asahiba/alpakka-improve/README.md

这是一个alpakka手柄的改版仓库
原项目地址：https://github.com/inputlabs
