asahiba/alpakka-improve/pcb/alpakka_D_C/preview.png

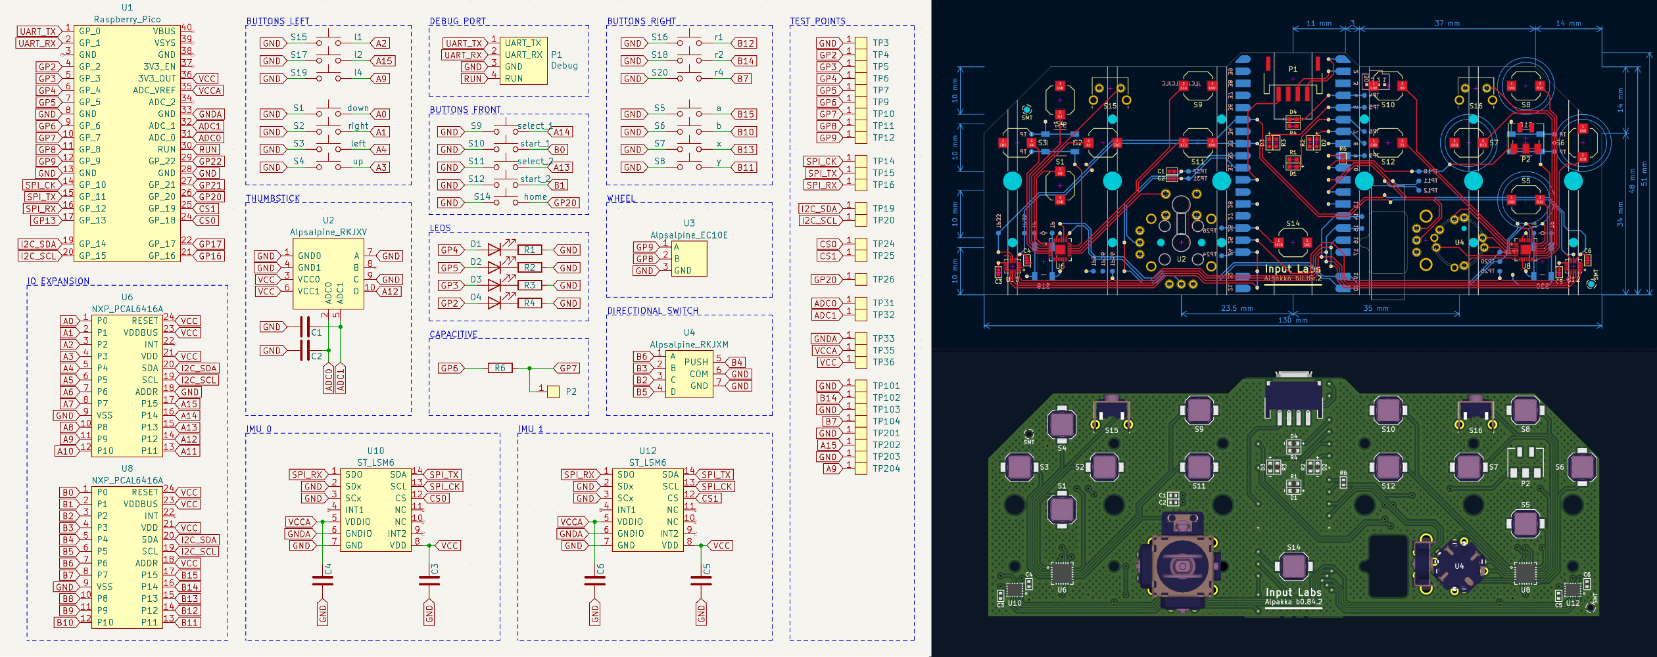
pcb/alpakka_D_C/preview.png
