asahiba/alpakka-improve/case/alpakka_D_C/stl/button_abxy.stl

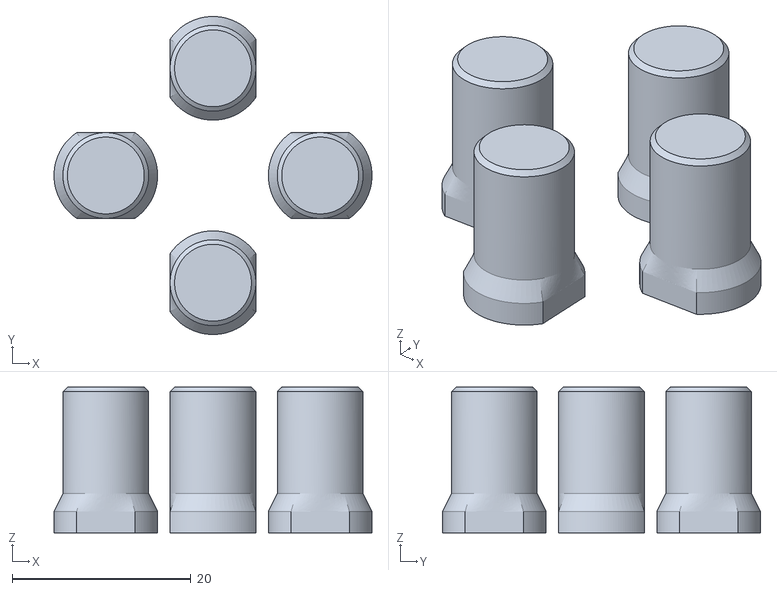
[picture p2: CAD file, 2025-08-04]
case/alpakka_D_C/stl/button_abxy.stl
35.6 x 35.6 x 16.3
