asahiba/alpakka-improve/case/alpakka_D_C/拓竹A1有线双摇杆标准化排版.3mf

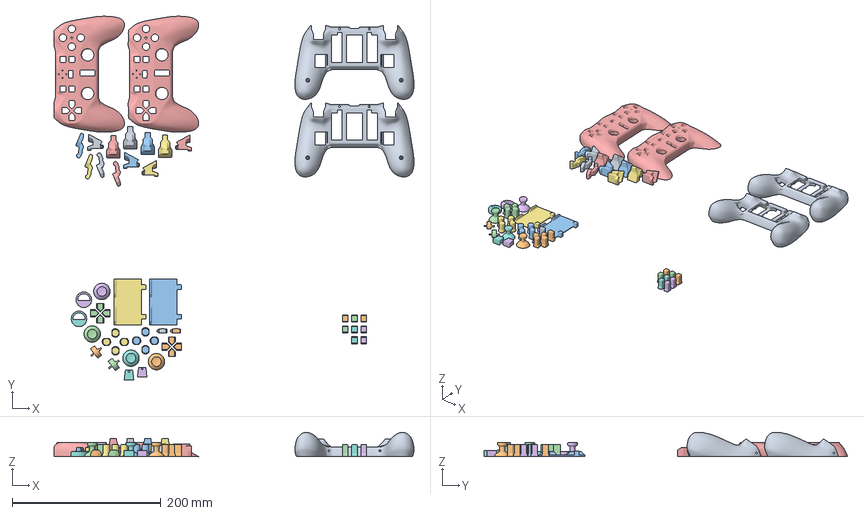
[picture p3: CAD file, 2025-08-04]
case/alpakka_D_C/拓竹A1有线双摇杆标准化排版.3mf
484.9 x 489.6 x 32.9 mm
case_back.stl x 2
007mm_select_4x.stl x 8
secondary_015mm_cover.stl x 2
Alpakka双摇杆[1.1.5][平整面壳][无八边形限位].stl x 2
button_abxy.stl x 2
primary_015mm_trigger_R2.stl x 4
button_dpad.stl x 2
007mm_thumbstick_L.stl x 4
primary_015mm_trigger_R4.stl x 2
primary_015mm_trigger_L4.stl x 2
secondary_015mm_wheel.stl x 2
primary_015mm_trigger_L1.stl x 2
secondary_007mm_wheel_core.stl x 2
primary_015mm_trigger_R1.stl x 2
any_015mm_wheel_holder.stl x 2
button_home.stl x 2
