asahiba/alpakka-improve/case/alpakka_D_C_M/B.stl

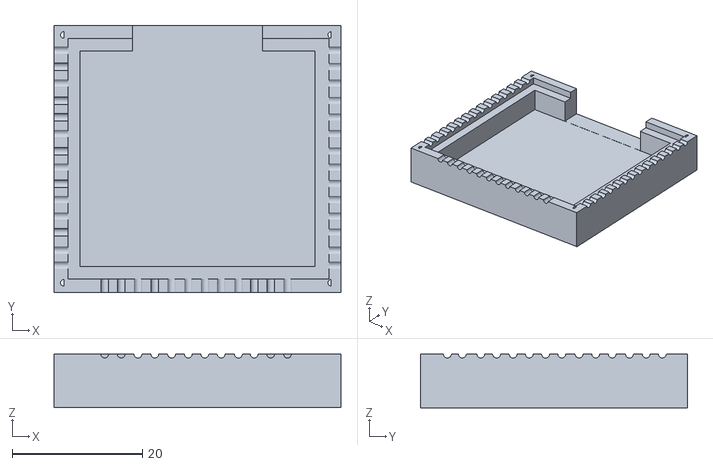
[picture p4: CAD file, 2025-08-05]
case/alpakka_D_C_M/B.stl
44.0 x 40.9 x 8.27
