asahiba/alpakka-improve/case/alpakka_D_W/A1无线圆润版标准化排版.3mf

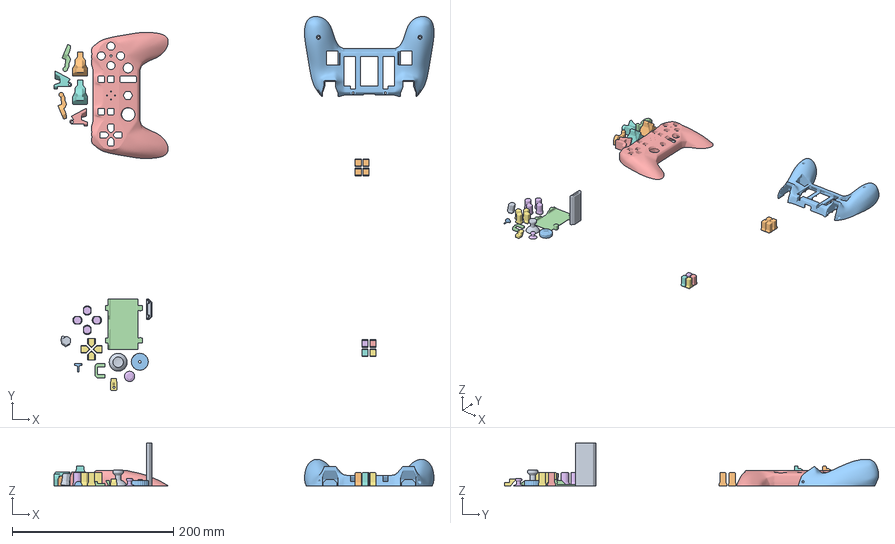
[picture p5: CAD file, 2025-08-04]
case/alpakka_D_W/A1无线圆润版标准化排版.3mf
470.7 x 463.5 x 52.7 mm
015mm_dongle_case.stl
组合体
case_back.stl
015mm_cover.stl
Alpakka无线版[官方1.0.1][圆润][无八边形限位].stl
button_abxy.stl
button_dpad.stl
015mm_trigger_L2.stl x 2
007mm_thumbstick_L.stl
015mm_wheel.stl
015mm_wheel_holder.stl
015mm_trigger_L4.stl
007mm_thumbstick_R.stl
015mm_anchors_2x.stl
015mm_trigger_R4.stl
007mm_home.stl
015mm_trigger_L1.stl
007mm_wheel_core.stl
015mm_trigger_R1.stl
007mm_select_4x.stl x 4
