asahiba/alpakka-improve/case/alpakka_S_C/Alpakka单摇杆home键.stl

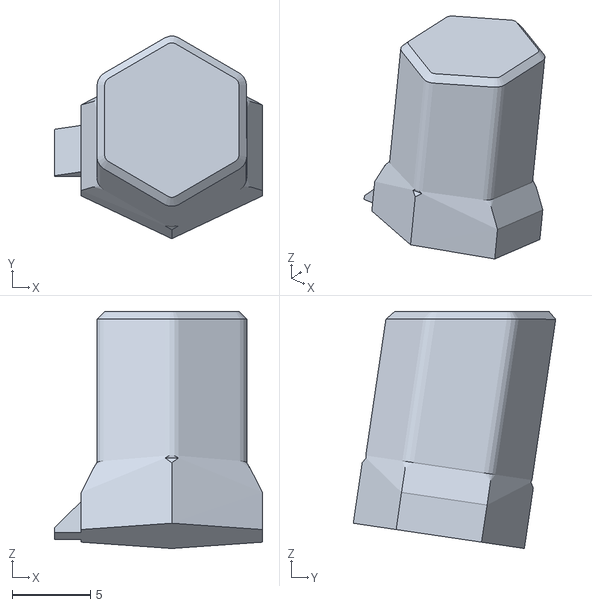
[picture p6: CAD file, 2025-08-04]
case/alpakka_S_C/Alpakka单摇杆home键.stl
13.3 x 12.9 x 15.2
