asahiba/alpakka-improve/case/alpakka_S_C/剩下的官方文件/any_015mm_wheel_holder.stl

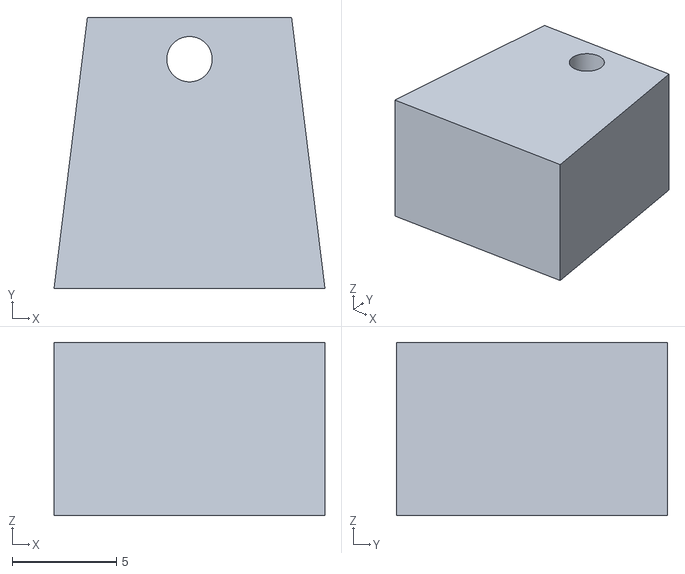
[picture p7: CAD file, 2025-08-04]
case/alpakka_S_C/剩下的官方文件/any_015mm_wheel_holder.stl
13.0 x 13.0 x 8.30
