asahiba/alpakka-improve/case/alpakka_D_C/stl/button_dpad.stl

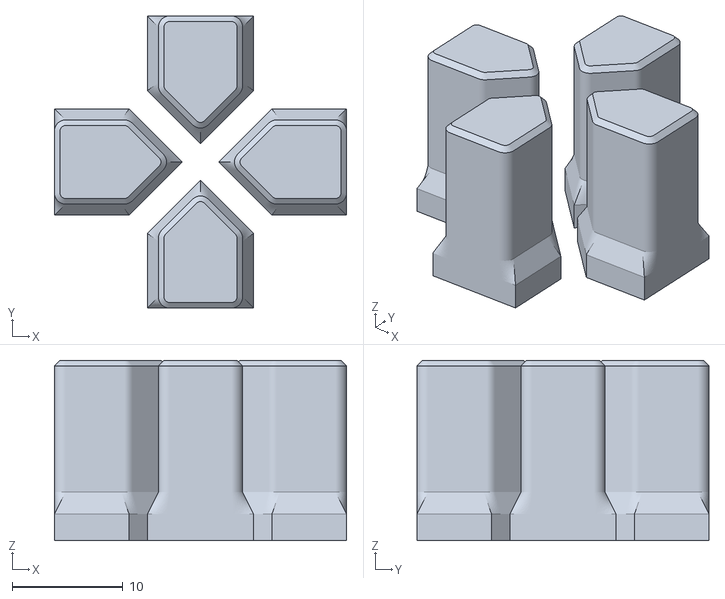
[picture p8: CAD file, 2025-08-04]
case/alpakka_D_C/stl/button_dpad.stl
26.4 x 26.4 x 16.3
