asahiba/alpakka-improve/case/alpakka_D_C_M/A.stl

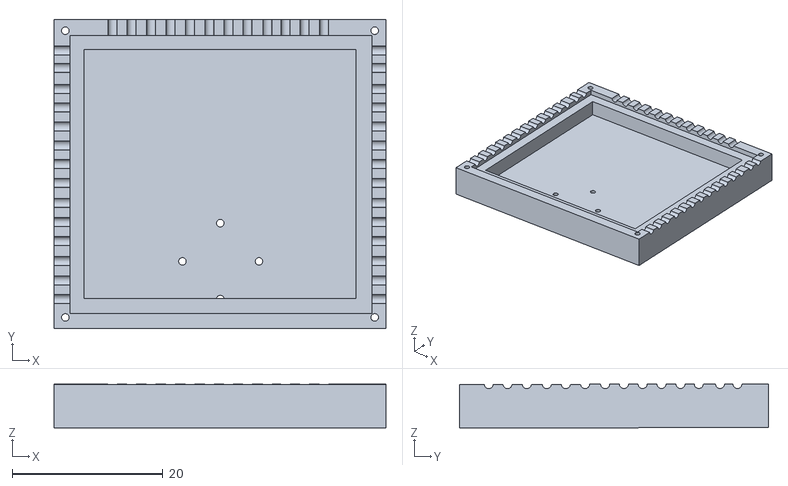
[picture p9: CAD file, 2025-08-05]
case/alpakka_D_C_M/A.stl
44.0 x 40.9 x 5.80
