asahiba/alpakka-improve/case/alpakka_S_C/Alpakka双摇杆home键.stl

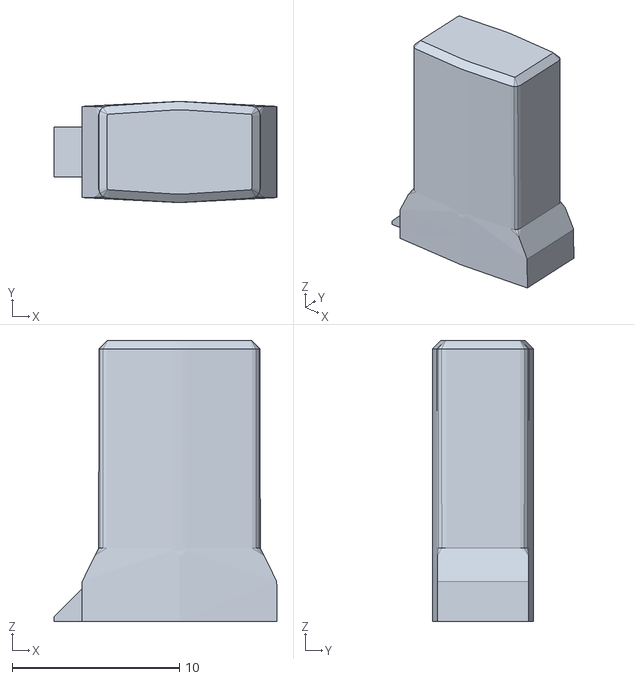
[picture p10: CAD file, 2025-08-04]
case/alpakka_S_C/Alpakka双摇杆home键.stl
13.3 x 6.06 x 16.8
