asahiba/alpakka-improve/case/alpakka_S_C/剩下的官方文件/secondary_015mm_wheel.stl

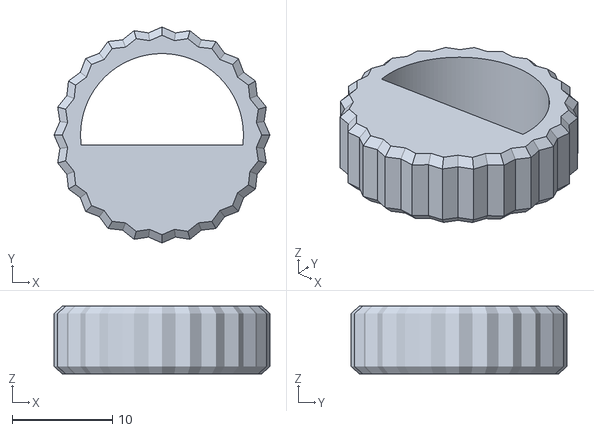
[picture p11: CAD file, 2025-08-04]
case/alpakka_S_C/剩下的官方文件/secondary_015mm_wheel.stl
21.5 x 21.5 x 6.75
