asahiba/alpakka-improve/case/alpakka_D_C/stl/case_front.stl

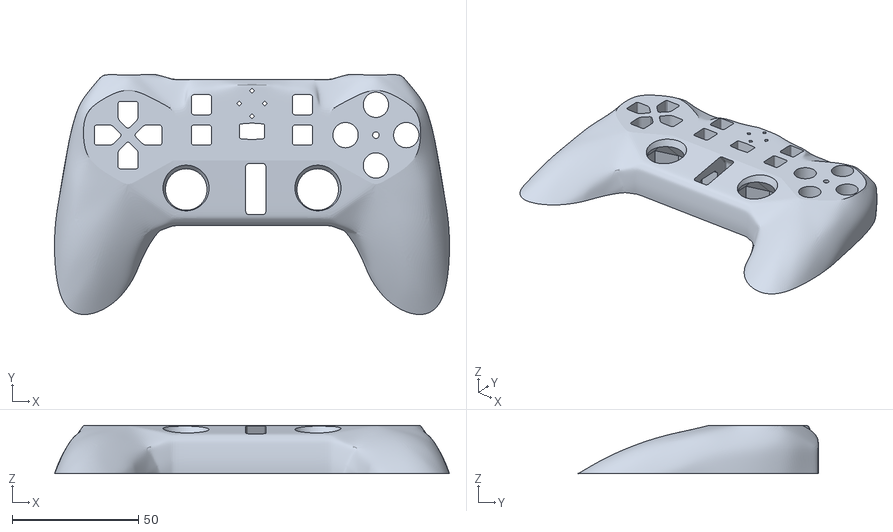
[picture p12: CAD file, 2025-08-04]
case/alpakka_D_C/stl/case_front.stl
156.2 x 94.9 x 19.0
