asahiba/alpakka-improve/case/alpakka_S_C/剩下的官方文件/secondary_007mm_wheel_core.stl

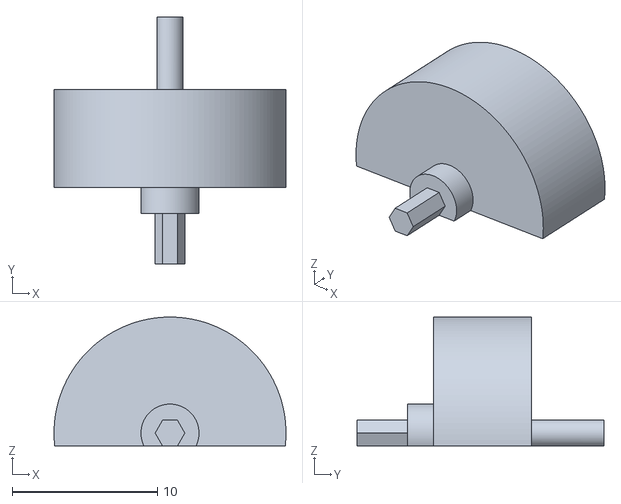
[picture p14: CAD file, 2025-08-04]
case/alpakka_S_C/剩下的官方文件/secondary_007mm_wheel_core.stl
16.0 x 17.1 x 8.89
