asahiba/alpakka-improve/case/alpakka_S_C/剩下的官方文件/primary_015mm_trigger_L4.stl

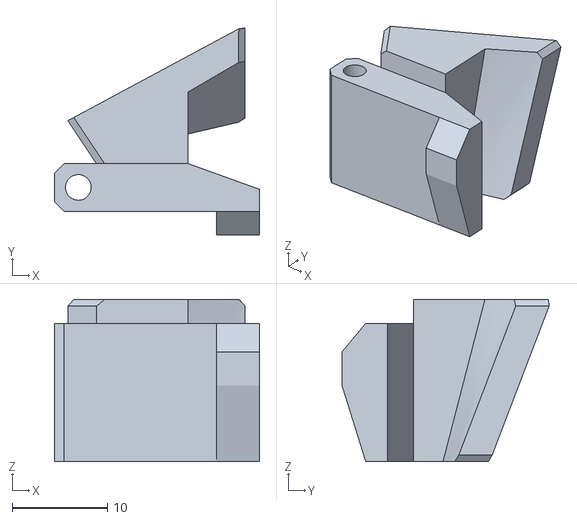
[picture p15: CAD file, 2025-08-04]
case/alpakka_S_C/剩下的官方文件/primary_015mm_trigger_L4.stl
21.5 x 21.7 x 17.0
