asahiba/alpakka-improve/case/alpakka_S_C/剩下的官方文件/primary_007mm_select_4x.stl

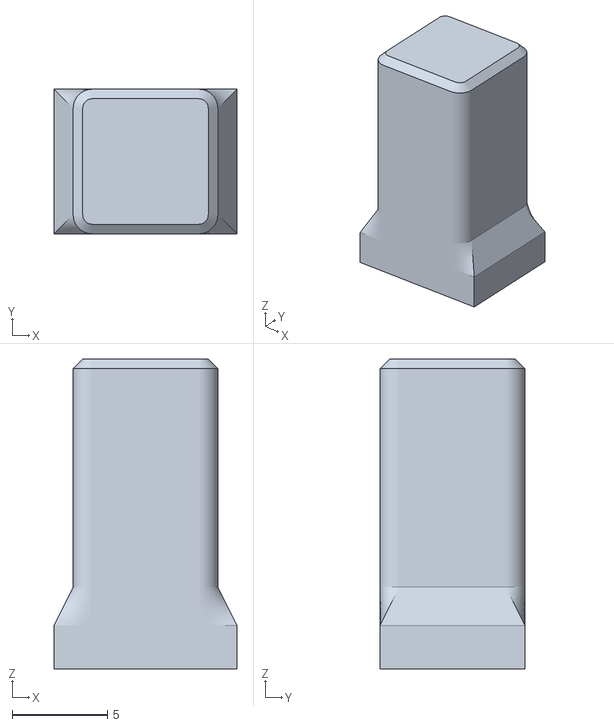
[picture p16: CAD file, 2025-08-04]
case/alpakka_S_C/剩下的官方文件/primary_007mm_select_4x.stl
9.60 x 7.60 x 16.3
