asahiba/alpakka-improve/case/alpakka_S_C/剩下的官方文件/secondary_015mm_cover.stl

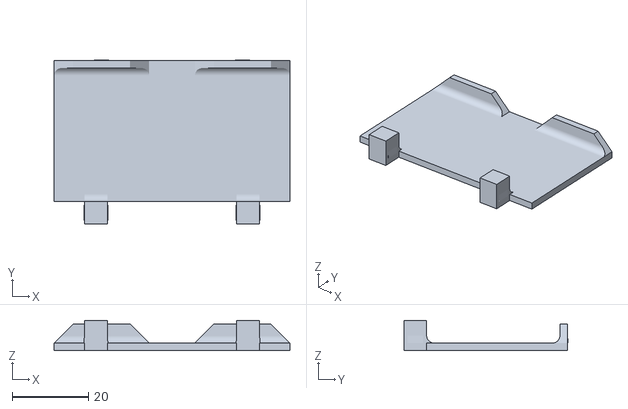
[picture p17: CAD file, 2025-08-04]
case/alpakka_S_C/剩下的官方文件/secondary_015mm_cover.stl
62.0 x 43.2 x 8.00
