asahiba/alpakka-improve/case/alpakka_S_C/剩下的官方文件/primary_015mm_trigger_L1.stl

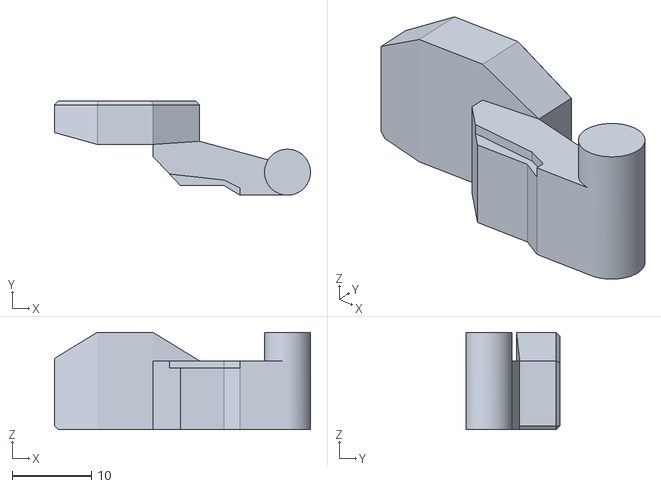
[picture p18: CAD file, 2025-08-04]
case/alpakka_S_C/剩下的官方文件/primary_015mm_trigger_L1.stl
32.3 x 11.9 x 12.3
