asahiba/alpakka-improve/case/alpakka_S_C/剩下的官方文件/primary_015mm_trigger_L2.stl

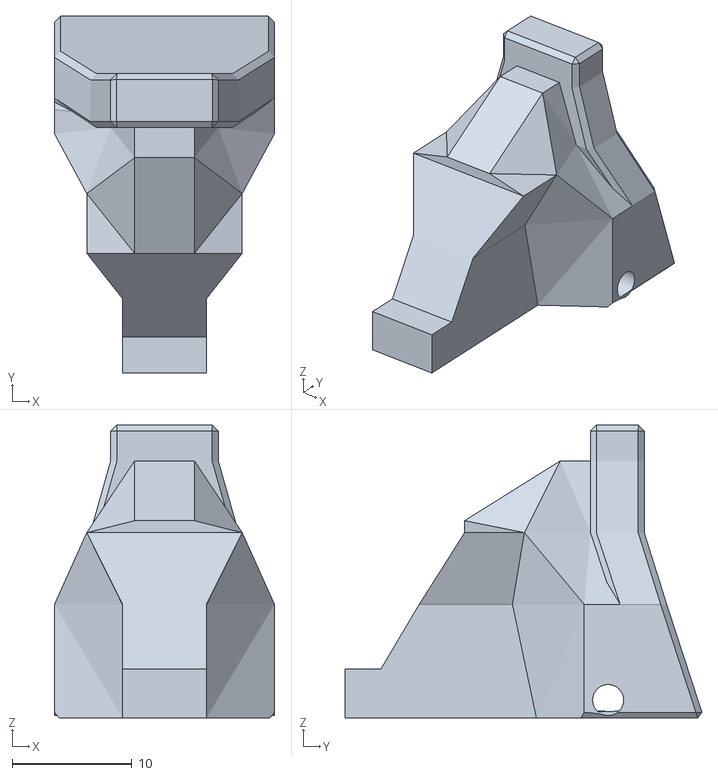
[picture p19: CAD file, 2025-08-04]
case/alpakka_S_C/剩下的官方文件/primary_015mm_trigger_L2.stl
18.4 x 29.8 x 24.5
