asahiba/alpakka-improve/(list of files, cad)

Other CAD files:
case/alpakka_S_C/Alpakka双摇杆[1.1.3]上壳.stl
case/alpakka_S_C/Alpakka单摇杆[优化3]上壳.stl
case/alpakka_S_C/剩下的官方文件/primary_015mm_trigger_R1.stl
case/alpakka_S_C/剩下的官方文件/primary_015mm_trigger_R4.stl
case/alpakka_D_C/blender/alpakka.blend
case/alpakka_D_C/blender/anchor.blend
case/alpakka_D_C/blender/button_abxy.blend
case/alpakka_D_C/blender/button_dpad.blend
case/alpakka_D_C/blender/button_home.blend
case/alpakka_D_C/blender/button_select.blend
case/alpakka_D_C/blender/case_back.blend
case/alpakka_D_C/blender/case_cover.blend
case/alpakka_D_C/blender/case_front.blend
case/alpakka_D_C/blender/hexagon.blend
case/alpakka_D_C/blender/hexagon_screwed.blend
case/alpakka_D_C/blender/lock.blend
case/alpakka_D_C/blender/pcb.blend
case/alpakka_D_C/blender/render.blend
case/alpakka_D_C/blender/scrollwheel.blend
case/alpakka_D_C/blender/shared.blend
case/alpakka_D_C/blender/soldering_stand.blend
case/alpakka_D_C/blender/thumbstick.blend
case/alpakka_D_C/blender/thumbstick_right.blend
case/alpakka_D_C/blender/trigger_R1.blend
case/alpakka_D_C/blender/trigger_R2.blend
case/alpakka_D_C/blender/trigger_R4.blend
case/alpakka_D_W/blender/alpakka.blend
case/alpakka_D_W/blender/anchor.blend
case/alpakka_D_W/blender/button_abxy.blend
case/alpakka_D_W/blender/button_dpad.blend
case/alpakka_D_W/blender/button_home.blend
case/alpakka_D_W/blender/button_select.blend
case/alpakka_D_W/blender/case_back.blend
case/alpakka_D_W/blender/case_cover.blend
case/alpakka_D_W/blender/case_front.blend
case/alpakka_D_W/blender/hexagon.blend
case/alpakka_D_W/blender/hexagon_screwed.blend
case/alpakka_D_W/blender/lock.blend
case/alpakka_D_W/blender/scrollwheel.blend
case/alpakka_D_W/blender/shared.blend
case/alpakka_D_W/blender/soldering_stand.blend
case/alpakka_D_W/blender/thumbstick.blend
case/alpakka_D_W/blender/trigger_R1.blend
case/alpakka_D_W/blender/trigger_R2.blend
case/alpakka_D_W/blender/trigger_R4.blend
