asahiba/alpakka-improve/pcb/alpakka_D_C_M/alpakka_D_C_M.kicad_pcb

## KiCad design pcb/alpakka_D_C_M/alpakka_D_C_M.kicad_pcb (2025-08-04)

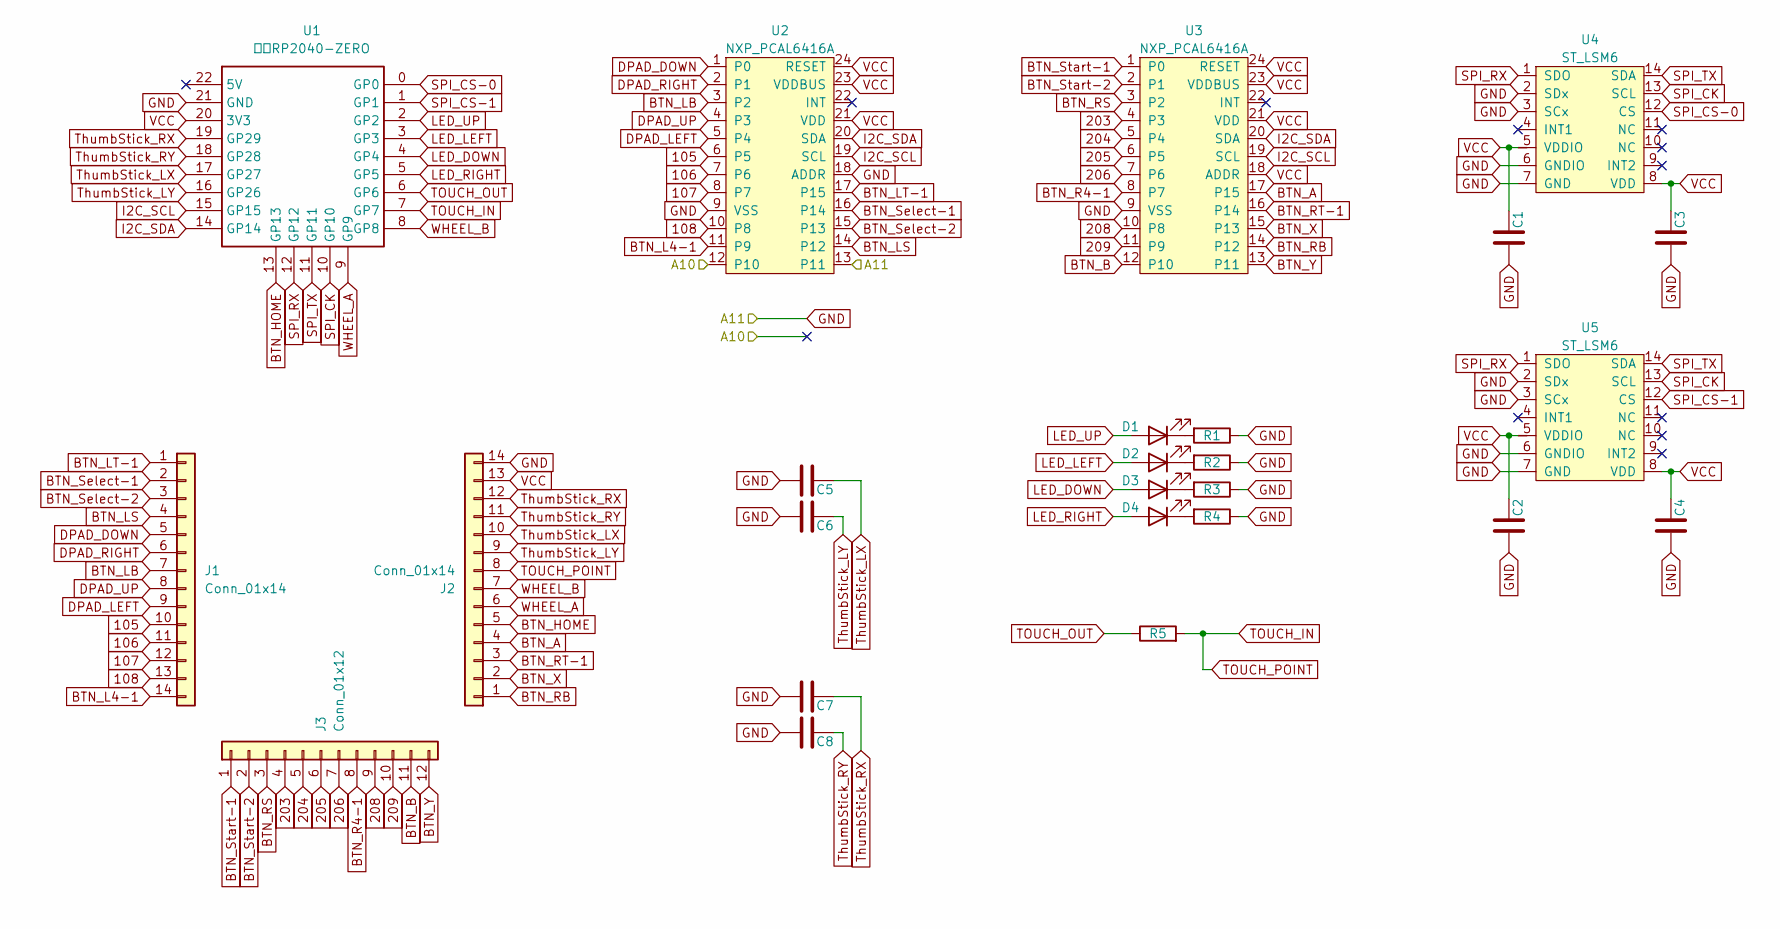
[picture p20: schematic alpakka_D_C_M.kicad_sch]

Parts:
C1, C2, C3, C4, C5, C6, C7, C8: C; 0402; LCSC C1525
D1, D2, D3, D4: Diode; 0603_d; LCSC C2290
J1, J2: Conn_01x14; 邮票孔排针1x14PIN_2.54MM
J3: Conn_01x12; 邮票孔排针1x12PIN_2.54MM
R1, R2, R3, R4: R; 0603; LCSC C22950
R5: R6; 0402; LCSC C11616
U1: 微雪RP2040-ZERO; RP2040-ZERO_SMT
U2, U3: NXP_PCAL6416A; QFN24; LCSC C2652287
U4, U5: ST_LSM6; LGA14; LCSC C784817

Connections:
105: J1.10, U2.6 (P5)
106: J1.11, U2.7 (P6)
107: J1.12, U2.8 (P7)
108: J1.13, U2.10 (P8)
203: J3.4, U3.4 (P3)
204: J3.5, U3.5 (P4)
205: J3.6, U3.6 (P5)
206: J3.7, U3.7 (P6)
208: J3.9, U3.10 (P8)
209: J3.10, U3.11 (P9)
/A10: U2.12 (P10)
BTN_A: J2.4, U3.17 (P15)
BTN_B: J3.11, U3.12 (P10)
BTN_HOME: J2.5, U1.13 (GP13)
BTN_L4-1: J1.14, U2.11 (P9)
BTN_LB: J1.7, U2.3 (P2)
BTN_LS: J1.4, U2.14 (P12)
BTN_LT-1: J1.1, U2.17 (P15)
BTN_R4-1: J3.8, U3.8 (P7)
BTN_RB: J2.1, U3.14 (P12)
BTN_RS: J3.3, U3.3 (P2)
BTN_RT-1: J2.3, U3.16 (P14)
BTN_Select-1: J1.2, U2.16 (P14)
BTN_Select-2: J1.3, U2.15 (P13)
BTN_Start-1: J3.1, U3.1 (P0)
BTN_Start-2: J3.2, U3.2 (P1)
BTN_X: J2.2, U3.15 (P13)
BTN_Y: J3.12, U3.13 (P11)
DPAD_DOWN: J1.5, U2.1 (P0)
DPAD_LEFT: J1.9, U2.5 (P4)
DPAD_RIGHT: J1.6, U2.2 (P1)
DPAD_UP: J1.8, U2.4 (P3)
GND: C1.1, C2.1, C3.1, C4.1, C5.1, C6.1, C7.1, C8.1, J2.14, R1.1, R2.1, R3.1, R4.1, U1.21 (GND), U2.9 (VSS), U2.13 (P11), U2.18 (ADDR), U3.9 (VSS), U4.2 (SDx), U4.3 (SCx), U4.6 (GNDIO), U4.7 (GND), U5.2 (SDx), U5.3 (SCx), U5.6 (GNDIO), U5.7 (GND)
I2C_SCL: U1.15 (GP15), U2.19 (SCL), U3.19 (SCL)
I2C_SDA: U1.14 (GP14), U2.20 (SDA), U3.20 (SDA)
LED_DOWN: D3.2 (A), U1.4 (GP4)
LED_LEFT: D2.2 (A), U1.3 (GP3)
LED_RIGHT: D4.2 (A), U1.5 (GP5)
LED_UP: D1.2 (A), U1.2 (GP2)
unnamed: D1.1 (K), R1.2
unnamed: D2.1 (K), R2.2
unnamed: D3.1 (K), R3.2
unnamed: D4.1 (K), R4.2
SPI_CK: U1.10 (GP10), U4.13 (SCL), U5.13 (SCL)
SPI_CS-0: U1.0 (GP0), U4.12 (CS)
SPI_CS-1: U1.1 (GP1), U5.12 (CS)
SPI_RX: U1.12 (GP12), U4.1 (SDO), U5.1 (SDO)
SPI_TX: U1.11 (GP11), U4.14 (SDA), U5.14 (SDA)
TOUCH_IN: J2.8, R5.2, U1.7 (GP7)
TOUCH_OUT: R5.1, U1.6 (GP6)
ThumbStick_LX: C5.2, J2.10, U1.17 (GP27)
ThumbStick_LY: C6.2, J2.9, U1.16 (GP26)
ThumbStick_RX: C7.2, J2.12, U1.19 (GP29)
ThumbStick_RY: C8.2, J2.11, U1.18 (GP28)
VCC: C1.2, C2.2, C3.2, C4.2, J2.13, U1.20 (3V3), U2.21 (VDD), U2.23 (VDDBUS), U2.24 (RESET), U3.18 (ADDR), U3.21 (VDD), U3.23 (VDDBUS), U3.24 (RESET), U4.5 (VDDIO), U4.8 (VDD), U5.5 (VDDIO), U5.8 (VDD)
WHEEL_A: J2.6, U1.9 (GP9)
WHEEL_B: J2.7, U1.8 (GP8)

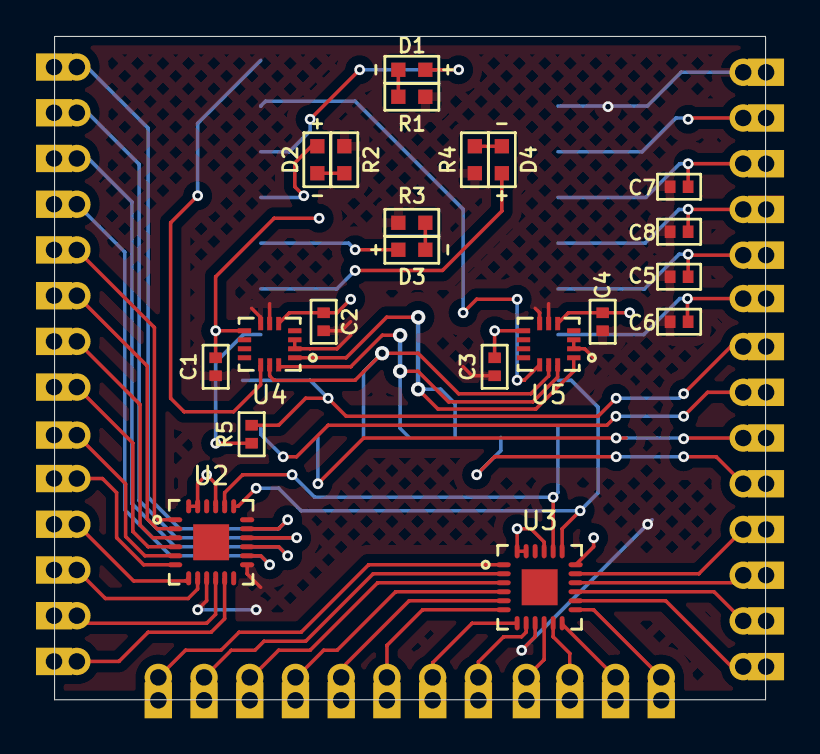
[picture p21: board alpakka_D_C_M.kicad_pcb from above]

Board: 2 copper layers, 39.5 x 36.9 mm, 25 parts (1 on the bottom side), 56 nets.
