asahiba/alpakka-improve/pcb/alpakka_D_C/projects/alpakka/alpakka.kicad_pcb

## KiCad design pcb/alpakka_D_C/projects/alpakka/alpakka.kicad_pcb (2025-08-04)

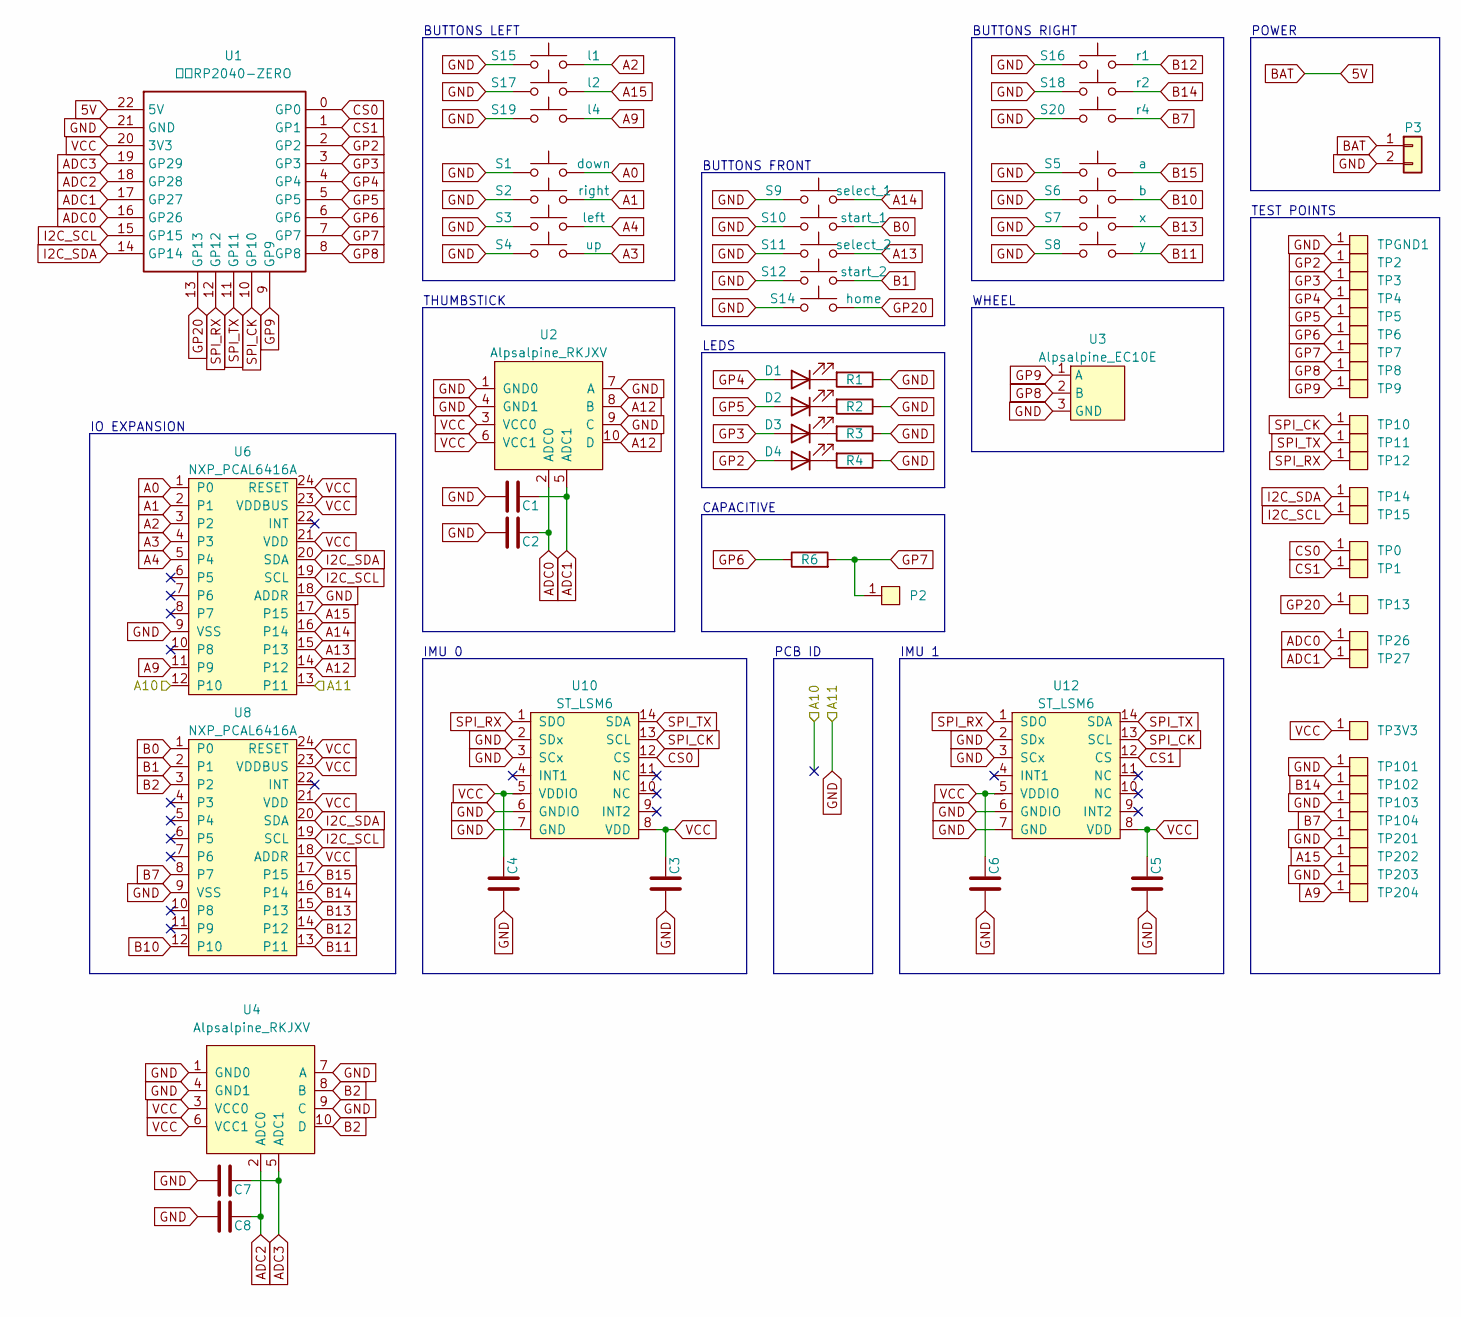
[picture p22: schematic alpakka.kicad_sch]

Parts:
C1, C2, C3, C4, C5, C6, C7, C8: C; 0402; LCSC C1525
D1, D2, D3, D4: Diode; 0603_d; LCSC C2290
P2: Endpoint; HRO_BC-25-3P; LCSC C707322
P3: Conn_01x02; JST_PH_2_TH
R1, R2, R3, R4: R; 0603; LCSC C22950
R6: R6; 0402; LCSC C11616
S1: down; Alpsalpine_SKPM; LCSC C115348
S2: right; Alpsalpine_SKPM; LCSC C115348
S3: left; Alpsalpine_SKPM; LCSC C115348
S4: up; Alpsalpine_SKPM; LCSC C115348
S5: a; Alpsalpine_SKPM; LCSC C115348
S6: b; Alpsalpine_SKPM; LCSC C115348
S7: x; Alpsalpine_SKPM; LCSC C115348
S8: y; Alpsalpine_SKPM; LCSC C115348
S9: select_1; Alpsalpine_SKPM; LCSC C115348
S10: start_1; Alpsalpine_SKPM; LCSC C115348
S11: select_2; Alpsalpine_SKPM; LCSC C115348
S12: start_2; Alpsalpine_SKPM; LCSC C115348
S14: home; Alpsalpine_SKPM; LCSC C115348
S15: l1; Alpsalpine_SKHHL; LCSC C125031
S16: r1; Alpsalpine_SKHHL; LCSC C125031
S17: l2; Alpsalpine_SKQG; LCSC C202424
S18: r2; Alpsalpine_SKQG; LCSC C202424
S19: l4; Alpsalpine_SKQG; LCSC C202424
S20: r4; Alpsalpine_SKQG; LCSC C202424
TP0, TP1, TP2, TP3, TP3V3, TP4, TP5, TP6, TP7, TP8, TP9, TP10, TP11, TP12, TP13, TP14, TP15, TP26, TP27, TP101, TP102, TP103, TP104, TP201, TP202, TP203, TP204: Endpoint; Pad_1mm
TPGND1: Endpoint; Pad_1mm
U1: 微雪RP2040-ZERO; PICOMINI
U2: Alpsalpine_RKJXV; Alpsalpine_RKJXV122400R; LCSC C918854
U3: Alpsalpine_EC10E; LCSC C110291
U4: Alpsalpine_RKJXV; Alpsalpine_RKJXV122400R
U6, U8: NXP_PCAL6416A; QFN24; LCSC C2652287
U10, U12: ST_LSM6; LGA14; LCSC C784817

Connections:
5V: P3.1, U1.22 (5V)
/A10: U6.12 (P10)
A0: S1.2, U6.1 (P0)
A1: S2.2, U6.2 (P1)
A2: S15.2, U6.3 (P2)
A3: S4.2, U6.4 (P3)
A4: S3.2, U6.5 (P4)
A9: S19.2, TP204.1, U6.11 (P9)
A12: U2.8 (B), U2.10 (D), U6.14 (P12)
A13: S11.2, U6.15 (P13)
A14: S9.2, U6.16 (P14)
A15: S17.2, TP202.1, U6.17 (P15)
ADC0: C2.2, TP26.1, U1.16 (GP26), U2.2 (ADC0)
ADC1: C1.2, TP27.1, U1.17 (GP27), U2.5 (ADC1)
ADC2: C8.2, U1.18 (GP28), U4.2 (ADC0)
ADC3: C7.2, U1.19 (GP29), U4.5 (ADC1)
B0: S10.2, U8.1 (P0)
B1: S12.2, U8.2 (P1)
B2: U4.8 (B), U4.10 (D), U8.3 (P2)
B7: S20.2, TP104.1, U8.8 (P7)
B10: S6.2, U8.12 (P10)
B11: S8.2, U8.13 (P11)
B12: S16.2, U8.14 (P12)
B13: S7.2, U8.15 (P13)
B14: S18.2, TP102.1, U8.16 (P14)
B15: S5.2, U8.17 (P15)
CS0: TP0.1, U1.0 (GP0), U10.12 (CS)
CS1: TP1.1, U1.1 (GP1), U12.12 (CS)
GND: C1.1, C2.1, C3.1, C4.1, C5.1, C6.1, C7.1, C8.1, P3.2, R1.1, R2.1, R3.1, R4.1, S1.1, S2.1, S3.1, S4.1, S5.1, S6.1, S7.1, S8.1, S9.1, S10.1, S11.1, S12.1, S14.1, S15.1, S16.1, S17.1, S18.1, S19.1, S20.1, TP101.1, TP103.1, TP201.1, TP203.1, TPGND1.1, U1.21 (GND), U2.1 (GND0), U2.4 (GND1), U2.7 (A), U2.9 (C), U3.3 (GND), U4.1 (GND0), U4.4 (GND1), U4.7 (A), U4.9 (C), U6.9 (VSS), U6.13 (P11), U6.18 (ADDR), U8.9 (VSS), U10.2 (SDx), U10.3 (SCx), U10.6 (GNDIO), U10.7 (GND), U12.2 (SDx), U12.3 (SCx), U12.6 (GNDIO), U12.7 (GND)
GP2: D4.2 (A), TP2.1, U1.2 (GP2)
GP3: D3.2 (A), TP3.1, U1.3 (GP3)
GP4: D1.2 (A), TP4.1, U1.4 (GP4)
GP5: D2.2 (A), TP5.1, U1.5 (GP5)
GP6: R6.1, TP6.1, U1.6 (GP6)
GP7: P2.1, R6.2, TP7.1, U1.7 (GP7)
GP8: TP8.1, U1.8 (GP8), U3.2 (B)
GP9: TP9.1, U1.9 (GP9), U3.1 (A)
GP20: S14.2, TP13.1, U1.13 (GP13)
I2C_SCL: TP15.1, U1.15 (GP15), U6.19 (SCL), U8.19 (SCL)
I2C_SDA: TP14.1, U1.14 (GP14), U6.20 (SDA), U8.20 (SDA)
unnamed: D1.1 (K), R1.2
unnamed: D2.1 (K), R2.2
unnamed: D3.1 (K), R3.2
unnamed: D4.1 (K), R4.2
SPI_CK: TP10.1, U1.10 (GP10), U10.13 (SCL), U12.13 (SCL)
SPI_RX: TP12.1, U1.12 (GP12), U10.1 (SDO), U12.1 (SDO)
SPI_TX: TP11.1, U1.11 (GP11), U10.14 (SDA), U12.14 (SDA)
VCC: C3.2, C4.2, C5.2, C6.2, TP3V3.1, U1.20 (3V3), U2.3 (VCC0), U2.6 (VCC1), U4.3 (VCC0), U4.6 (VCC1), U6.21 (VDD), U6.23 (VDDBUS), U6.24 (RESET), U8.18 (ADDR), U8.21 (VDD), U8.23 (VDDBUS), U8.24 (RESET), U10.5 (VDDIO), U10.8 (VDD), U12.5 (VDDIO), U12.8 (VDD)

Notes on the sheet:
WHEEL
THUMBSTICK
IMU 0
PCB ID
IMU 1
BUTTONS FRONT
TEST POINTS
CAPACITIVE
IO EXPANSION
LEDS
BUTTONS LEFT
BUTTONS RIGHT
POWER

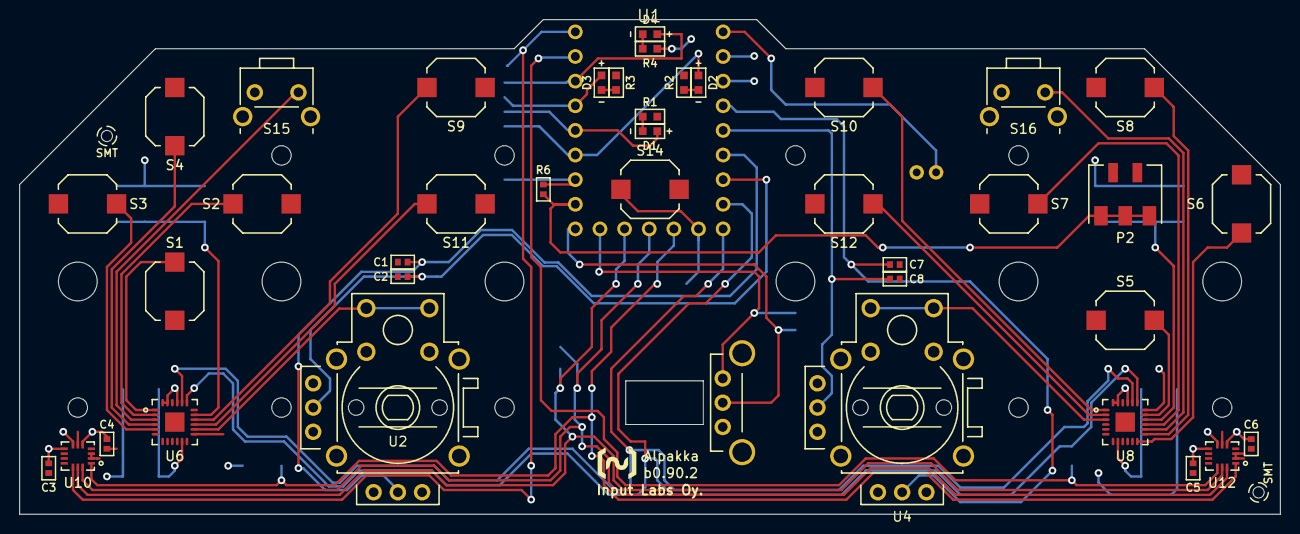
[picture p23: board alpakka.kicad_pcb from above]

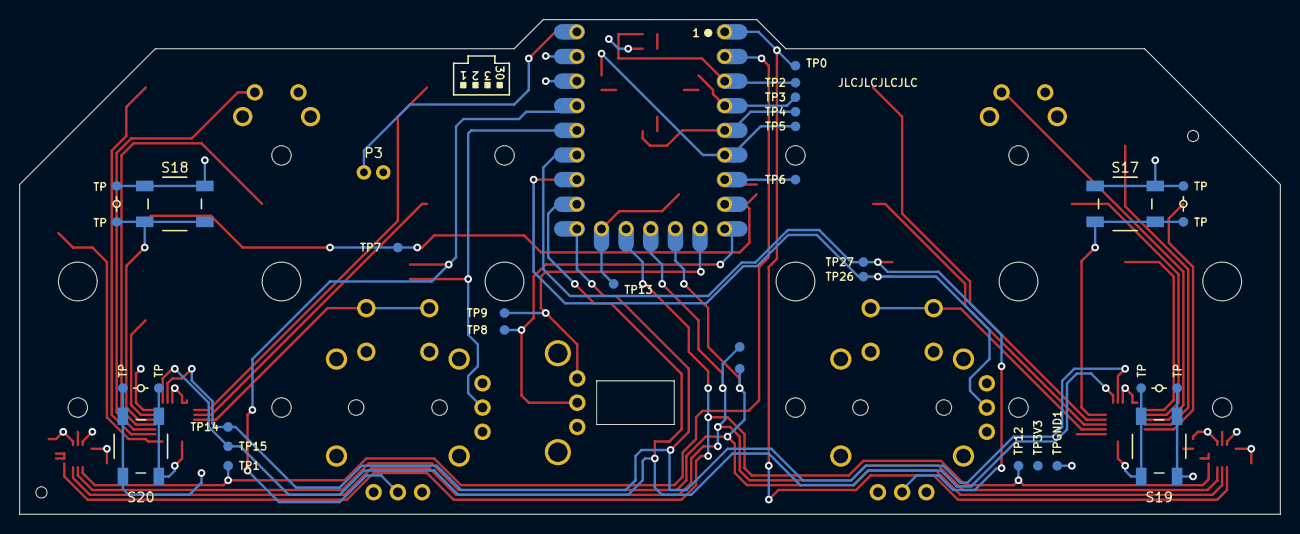
[picture p24: board alpakka.kicad_pcb from below]

Board: 2 copper layers, 130.0 x 51.0 mm, 74 parts (34 on the bottom side), 47 nets.
