asahiba/alpakka-improve/pcb/marmota_D_W/projects/marmota/marmota.kicad_pcb

## KiCad design pcb/marmota_D_W/projects/marmota/marmota.kicad_pcb (2025-08-04)

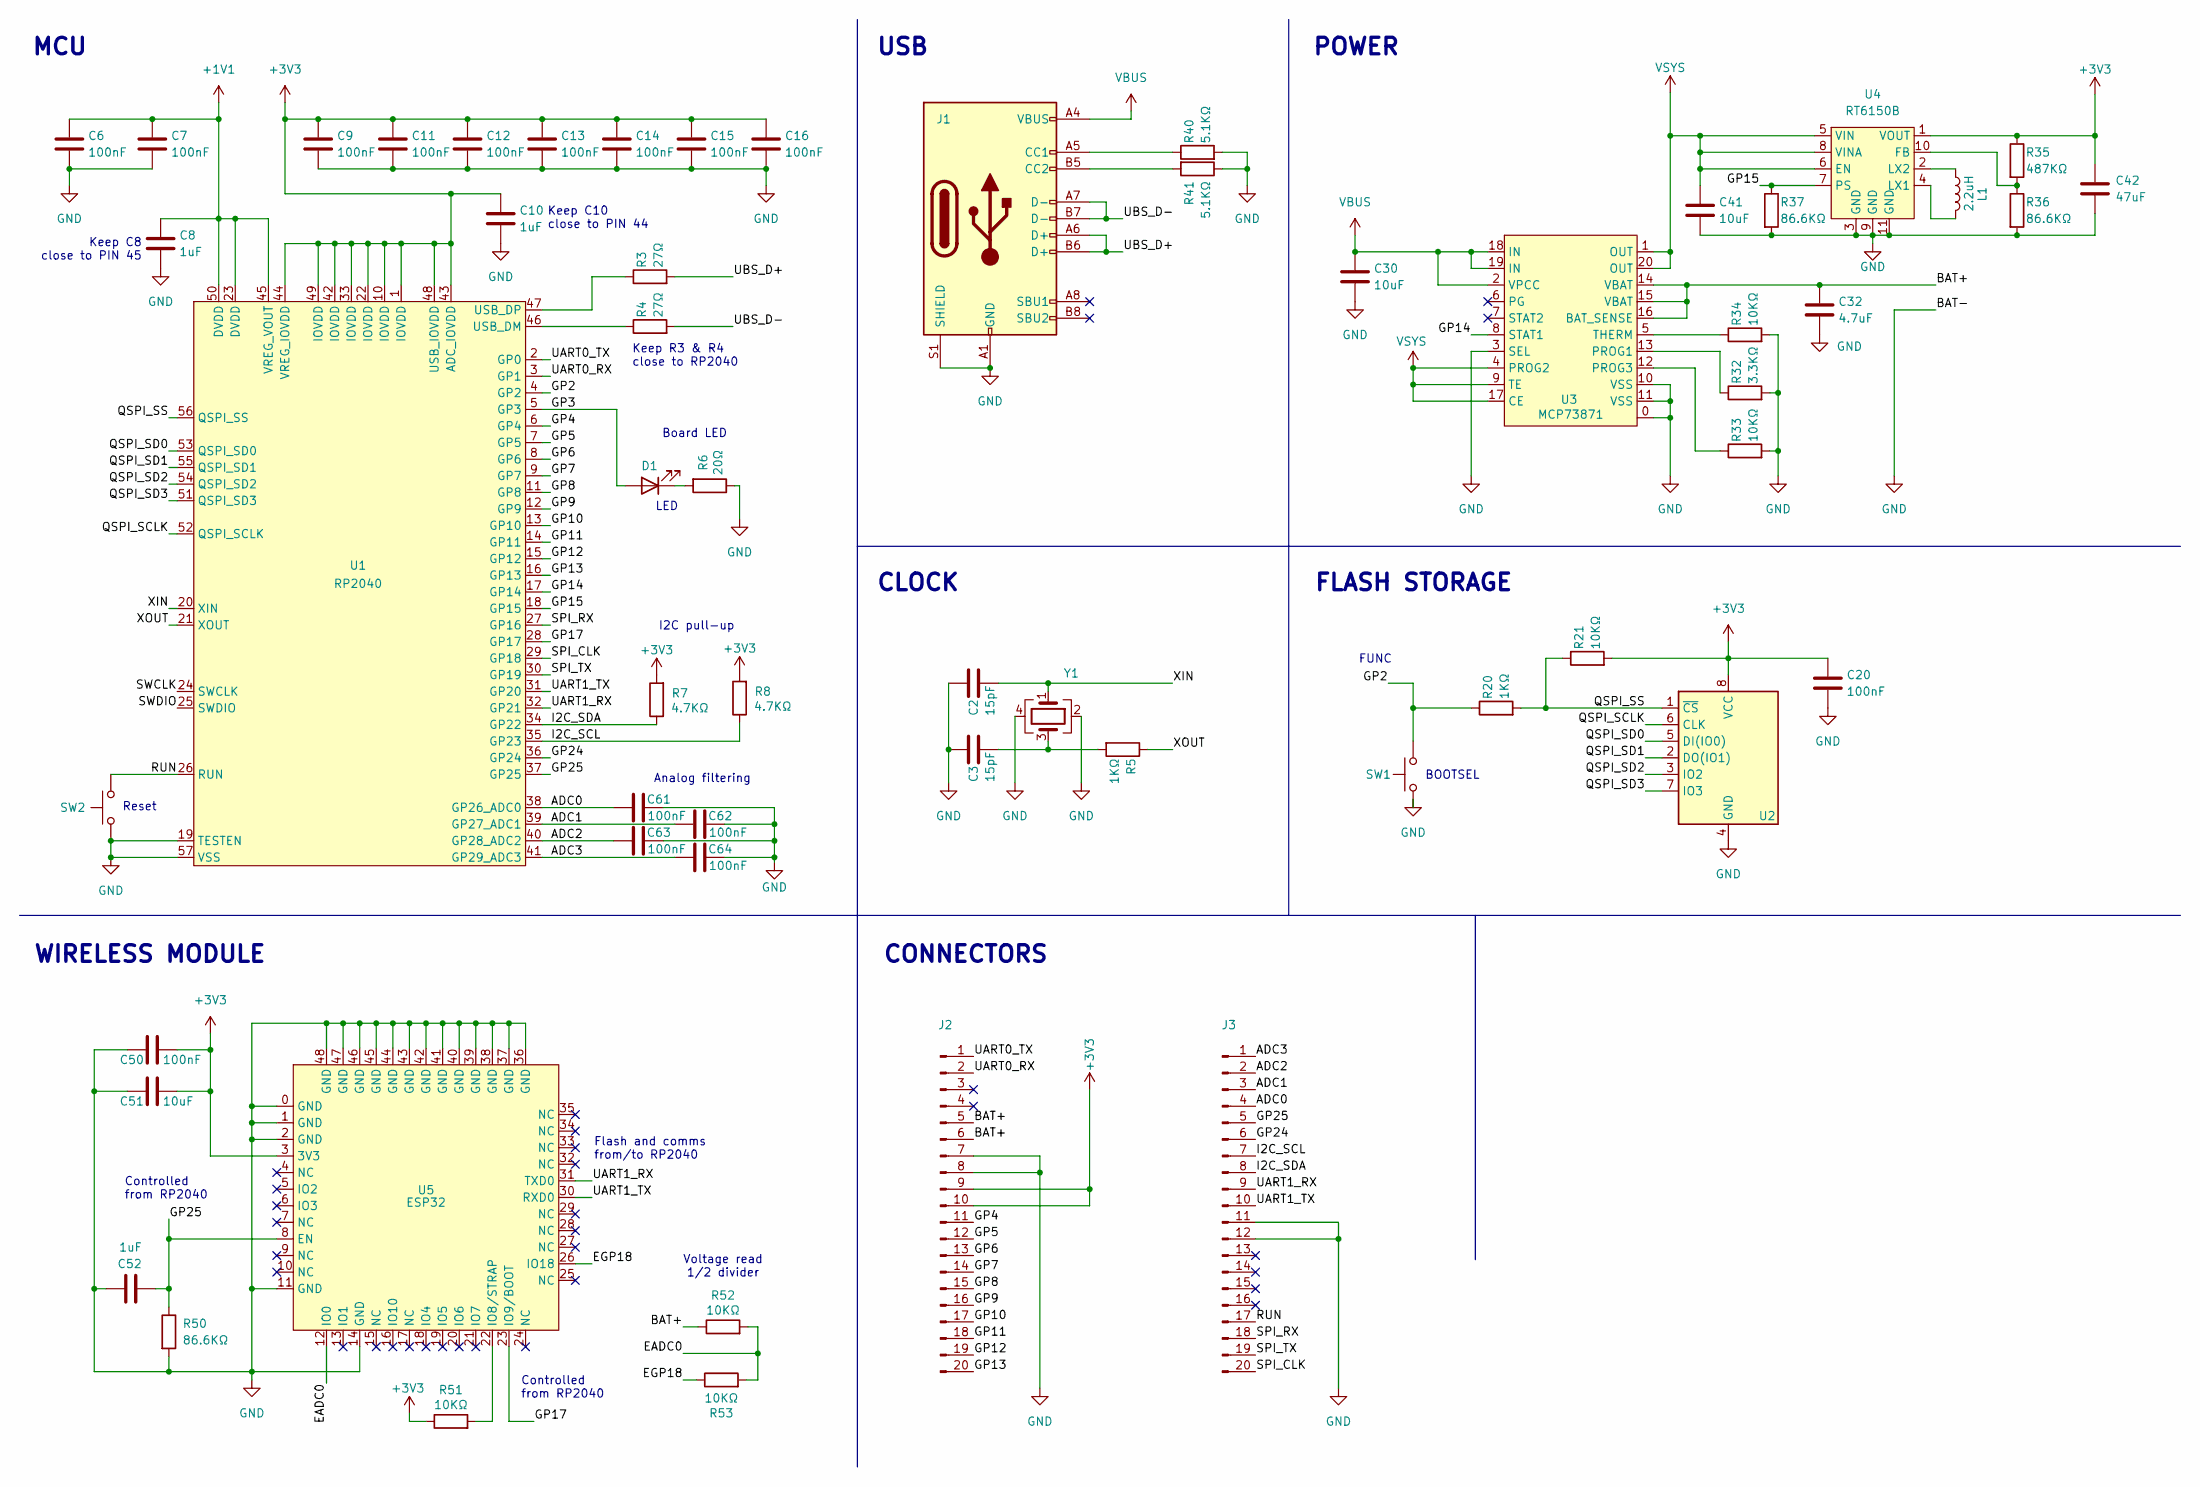
[picture p25: schematic marmota.kicad_sch]

Parts:
C2, C3: 15pF; 0402_compact; LCSC C1548
C6, C7, C9, C11, C12, C13, C14, C15, C16, C20, C50, C61, C62, C63, C64: 100nF; 0402_compact; LCSC C1525
C8, C10, C52: 1uF; 0402_compact; LCSC C52923
C30, C41, C51: 10uF; 0402_compact; LCSC C15525
C32: 4.7uF; 0402_compact; LCSC C23733
C42: 47uF; 0603_compact; LCSC C730416
D1: Diode; 0603_d; LCSC C2290
J1: USB_C; USB_C3019717; LCSC C3019717
J2, J3: Conn_01x20_Pin; Hirose_DF12NB; LCSC C2917815
L1: 2.2uH; 0603_compact; LCSC C394950
R3, R4: 27Ω; 0402_compact; LCSC C25100
R5, R20: 1KΩ; 0402_compact; LCSC C11702
R6: 20Ω; 0603; LCSC C22950
R7, R8: 4.7KΩ; 0402_compact; LCSC C25900
R21, R33, R34, R51, R52, R53: 10KΩ; 0402_compact; LCSC C25744
R32: 3.3KΩ; 0402_compact; LCSC C137992
R35: 487KΩ; 0402_compact; LCSC C321533
R36, R37, R50: 86.6KΩ; 0402_compact; LCSC C19709
R40, R41: 5.1KΩ; 0402_compact; LCSC C25905
SW1: Button top; Alpsalpine_SKRP_compact; LCSC C139797
SW2: Button side; Alpsalpine_SKSC; LCSC C115362
U1: RP2040; QFN-56-1EP_7x7mm_P0.4mm_EP3.2x3.2mm; LCSC C2040
U2: FLASH; Winbond_W25Q; LCSC C2843335
U3: MCP73871; QFN20_internal_routing; LCSC C511310
U4: RT6150B; WDFN-10L-2.5x2.5; LCSC C147972
U5: ESP32; Espressif_ESP32_mini; LCSC C3013915
Y1: 12MHz; Crystal_SMD_2520-4Pin_2.5x2.0mm; LCSC C2896601

Connections:
+1V1: C6.2, C7.2, C8.2, U1.23 (DVDD), U1.45 (VREG_VOUT), U1.50 (DVDD)
+3V3: C9.2, C10.2, C11.2, C12.2, C13.2, C14.2, C15.2, C16.2, C20.2, C42.2, C50.2, C51.2, J2.9, J2.10, R7.2, R8.2, R21.2, R35.1, R51.1, U1.1 (IOVDD), U1.10 (IOVDD), U1.22 (IOVDD), U1.33 (IOVDD), U1.42 (IOVDD), U1.43 (ADC_IOVDD), U1.44 (VREG_IOVDD), U1.48 (USB_IOVDD), U1.49 (IOVDD), U2.8 (VCC), U4.1 (VOUT), U5.3 (3V3)
/ADC0: C61.2, J3.4, U1.38 (GP26_ADC0)
/ADC1: C62.2, J3.3, U1.39 (GP27_ADC1)
/ADC2: C63.2, J3.2, U1.40 (GP28_ADC2)
/ADC3: C64.2, J3.1, U1.41 (GP29_ADC3)
/BAT+: C32.2, J2.5, J2.6, R52.1, U3.14 (VBAT), U3.15 (VBAT), U3.16 (BAT_SENSE)
/EADC0: R52.2, R53.2, U5.12 (IO0)
/EGP18: R53.1, U5.26 (IO18)
/GP2: R20.1, SW1.2, U1.4 (GP2)
/GP3: D1.2 (A), U1.5 (GP3)
/GP4: J2.11, U1.6 (GP4)
/GP5: J2.12, U1.7 (GP5)
/GP6: J2.13, U1.8 (GP6)
/GP7: J2.14, U1.9 (GP7)
/GP8: J2.15, U1.11 (GP8)
/GP9: J2.16, U1.12 (GP9)
/GP10: J2.17, U1.13 (GP10)
/GP11: J2.18, U1.14 (GP11)
/GP12: J2.19, U1.15 (GP12)
/GP13: J2.20, U1.16 (GP13)
/GP14: U1.17 (GP14), U3.8 (STAT1)
/GP15: R37.1, U1.18 (GP15), U4.7 (PS)
/GP17: U1.28 (GP17), U5.23 (IO9/BOOT)
/GP24: J3.6, U1.36 (GP24)
/GP25: C52.1, J3.5, R50.1, U1.37 (GP25), U5.8 (EN)
/I2C_SCL: J3.7, R8.1, U1.35 (GP23)
/I2C_SDA: J3.8, R7.1, U1.34 (GP22)
/QSPI_SCLK: U1.52 (QSPI_SCLK), U2.6 (CLK)
/QSPI_SD0: U1.53 (QSPI_SD0), U2.5 (DI(IO0))
/QSPI_SD1: U1.55 (QSPI_SD1), U2.2 (DO(IO1))
/QSPI_SD2: U1.54 (QSPI_SD2), U2.3 (IO2)
/QSPI_SD3: U1.51 (QSPI_SD3), U2.7 (IO3)
/QSPI_SS: R20.2, R21.1, U1.56 (QSPI_SS), U2.1 (~CS)
/RUN: J3.17, SW2.2, U1.26 (RUN)
/SPI_CLK: J3.20, U1.29 (GP18)
/SPI_RX: J3.18, U1.27 (GP16)
/SPI_TX: J3.19, U1.30 (GP19)
/SWCLK: U1.24 (SWCLK)
/SWDIO: U1.25 (SWDIO)
/UART0_RX: J2.2, U1.3 (GP1)
/UART0_TX: J2.1, U1.2 (GP0)
/UART1_RX: J3.9, U1.32 (GP21), U5.31 (TXD0)
/UART1_TX: J3.10, U1.31 (GP20), U5.30 (RXD0)
/UBS_D+: J1.A6 (D+), J1.B6 (D+), R3.2
/UBS_D-: J1.A7 (D-), J1.B7 (D-), R4.2
/XIN: C2.1, U1.20 (XIN), Y1.1
/XOUT: R5.1, U1.21 (XOUT)
GND: C2.2, C3.2, C6.1, C7.1, C8.1, C9.1, C10.1, C11.1, C12.1, C13.1, C14.1, C15.1, C16.1, C20.1, C30.1, C32.1, C41.1, C42.1, C50.1, C51.1, C52.2, C61.1, C62.1, C63.1, C64.1, J1.A1 (GND), J1.A12 (GND), J1.B1 (GND), J1.B12 (GND), J1.S1 (SHIELD), J2.7, J2.8, J3.11, J3.12, R6.1, R32.2, R33.2, R34.2, R36.2, R37.2, R40.2, R41.1, R50.2, SW1.1, SW2.1, U1.19 (TESTEN), U1.57 (VSS), U2.4 (GND), U3.0, U3.3 (SEL), U3.10 (VSS), U3.11 (VSS), U4.3 (GND), U4.9 (GND), U4.11 (GND), U5.0 (GND), U5.1 (GND), U5.2 (GND), U5.11 (GND), U5.14 (GND), U5.36 (GND), U5.37 (GND), U5.38 (GND), U5.39 (GND), U5.40 (GND), U5.41 (GND), U5.42 (GND), U5.43 (GND), U5.44 (GND), U5.45 (GND), U5.46 (GND), U5.47 (GND), U5.48 (GND), Y1.2, Y1.4
unnamed: C3.1, R5.2, Y1.3
unnamed: D1.1 (K), R6.2
unnamed: J1.A5 (CC1), R40.1
unnamed: J1.B5 (CC2), R41.2
unnamed: R4.1, U1.46 (USB_DM)
unnamed: R3.1, U1.47 (USB_DP)
unnamed: R32.1, U3.13 (PROG1)
unnamed: R33.1, U3.12 (PROG3)
unnamed: R34.1, U3.5 (THERM)
unnamed: R35.2, R36.1, U4.10 (FB)
unnamed: L1.2, U4.4 (LX1)
unnamed: L1.1, U4.2 (LX2)
unnamed: R51.2, U5.22 (IO8/STRAP)
VBUS: C30.2, J1.A4 (VBUS), J1.A9 (VBUS), J1.B4 (VBUS), J1.B9 (VBUS), U3.2 (VPCC), U3.18 (IN), U3.19 (IN)
VSYS: C41.2, U3.1 (OUT), U3.4 (PROG2), U3.9 (TE), U3.17 (CE), U3.20 (OUT), U4.5 (VIN), U4.6 (EN), U4.8 (VINA)

Notes on the sheet:
POWER
CONNECTORS
Analog filtering
Board LED
USB
Keep R3 & R4 close to RP2040
WIRELESS MODULE
Reset
Keep C8 close to PIN 45
Controlled from RP2040
Voltage read 1/2 divider
CLOCK
FUNC
LED
BOOTSEL
FLASH STORAGE
Keep C10 close to PIN 44
I2C pull-up
Flash and comms from/to RP2040
MCU

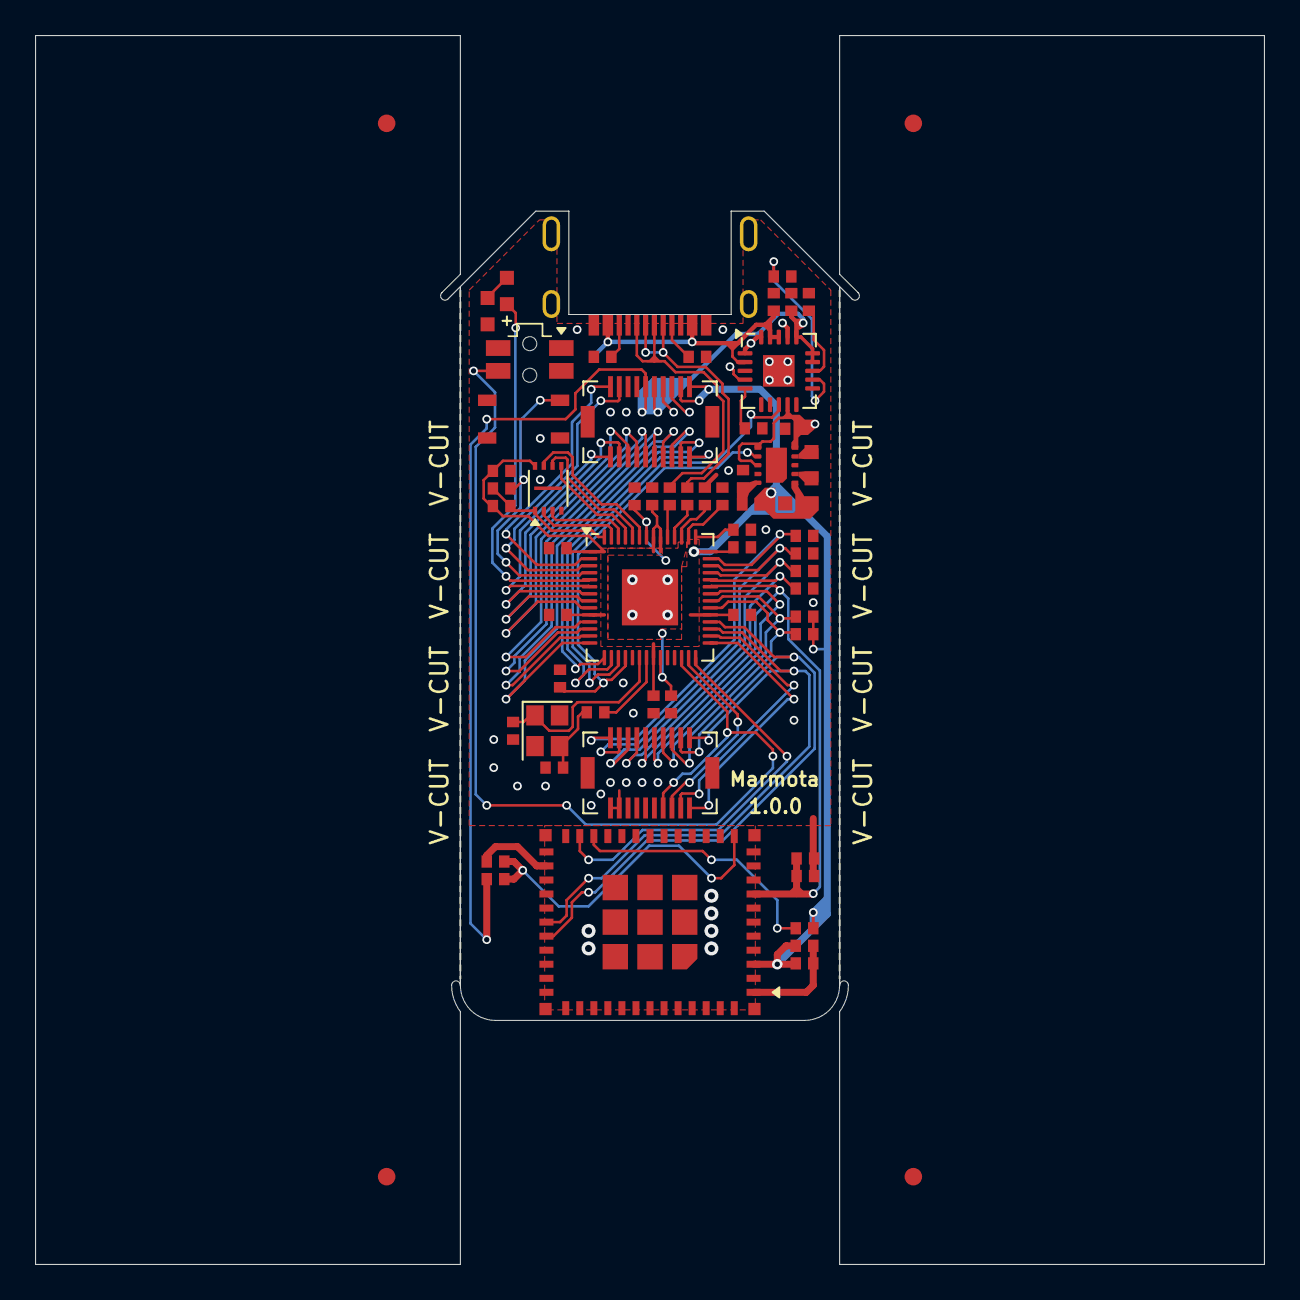
[picture p26: board marmota.kicad_pcb from above]

Board: 2 copper layers, 70.0 x 70.0 mm, 58 parts (0 on the bottom side), 62 nets.
