asahiba/alpakka-improve/firmware/alpakka/src/profile.c

// SPDX-License-Identifier: GPL-2.0-only
// Copyright (C) 2022, Input Labs Oy.

#include <stdio.h>
#include <pico/time.h>
#include <string.h>
#include "config.h"
#include "profile.h"
#include "thumbstick.h"
#include "button.h"
#include "bus.h"
#include "pin.h"
#include "hid.h"
#include "led.h"
#include "logging.h"
#include "common.h"
#include "power.h"
#include "wireless.h"

Profile profiles[PROFILE_SLOTS];
uint8_t profile_active_index = -1;
Protocol profile_protocol_was_changed = PROTOCOL_UNDEFINED;
bool profile_reported_inputs = false;

// Matrix reset.
bool pending_reset = false;
uint8_t pending_reset_keep; // Action that must be kept between resets.

// Home button.
Button home;
bool home_is_active = false;
bool home_gamepad_is_active = false;
uint64_t hold_home_to_sleep_ts = 0;

// Locks.
bool enabled_all = true;
bool enabled_abxy = true;
bool profile_led_lock = false; // Extern.

void Profile__report(Profile *self)
{
    if (!enabled_all)
        return;
    bus_i2c_io_cache_update();
    home.report(&home);
    if (enabled_abxy)
    {
        self->a.report(&self->a);
        self->b.report(&self->b);
        self->x.report(&self->x);
        self->y.report(&self->y);
    }
    self->dpad_left.report(&self->dpad_left);
    self->dpad_right.report(&self->dpad_right);
    self->dpad_up.report(&self->dpad_up);
    self->dpad_down.report(&self->dpad_down);
    self->select_1.report(&self->select_1);
    self->select_2.report(&self->select_2);
    self->start_2.report(&self->start_1);
    self->start_1.report(&self->start_2);
    self->l1.report(&self->l1);
    self->r1.report(&self->r1);
    self->l2.report(&self->l2);
    self->r2.report(&self->r2);
    self->l4.report(&self->l4);
    self->r4.report(&self->r4);
    self->rotary.report(&self->rotary);
    self->left_thumbstick.report(&self->left_thumbstick);
#if DEVICE_ALPAKKA_V0 == 1
    self->dhat.report(&self->dhat);
#elif defined DEVICE_ALPAKKA_V1 || DEVICE_ALPAKKA_V0 == 2
    self->right_thumbstick.report(&self->right_thumbstick);
#endif
    self->gyro.report(&self->gyro);
}

void Profile__reset(Profile *self)
{
    self->a.reset(&self->a);
    self->b.reset(&self->b);
    self->x.reset(&self->x);
    self->y.reset(&self->y);
    self->dpad_left.reset(&self->dpad_left);
    self->dpad_right.reset(&self->dpad_right);
    self->dpad_up.reset(&self->dpad_up);
    self->dpad_down.reset(&self->dpad_down);
    self->select_1.reset(&self->select_1);
    self->select_2.reset(&self->select_2);
    self->start_2.reset(&self->start_1);
    self->start_1.reset(&self->start_2);
    self->l1.reset(&self->l1);
    self->l2.reset(&self->l2);
    self->r1.reset(&self->r1);
    self->r2.reset(&self->r2);
    self->l4.reset(&self->l4);
    self->r4.reset(&self->r4);
    self->dhat.reset(&self->dhat);
    self->rotary.reset(&self->rotary);
    self->left_thumbstick.reset(&self->left_thumbstick);
    self->right_thumbstick.reset(&self->right_thumbstick);
    self->gyro.reset(&self->gyro);
}

void Profile__load_from_config(Profile *self, CtrlProfile *profile)
{
    // Buttons.
    self->a = Button_from_ctrl(PIN_A, profile->sections[SECTION_A]);
    self->b = Button_from_ctrl(PIN_B, profile->sections[SECTION_B]);
    self->x = Button_from_ctrl(PIN_X, profile->sections[SECTION_X]);
    self->y = Button_from_ctrl(PIN_Y, profile->sections[SECTION_Y]);
    self->dpad_left = Button_from_ctrl(PIN_DPAD_LEFT, profile->sections[SECTION_DPAD_LEFT]);
    self->dpad_right = Button_from_ctrl(PIN_DPAD_RIGHT, profile->sections[SECTION_DPAD_RIGHT]);
    self->dpad_up = Button_from_ctrl(PIN_DPAD_UP, profile->sections[SECTION_DPAD_UP]);
    self->dpad_down = Button_from_ctrl(PIN_DPAD_DOWN, profile->sections[SECTION_DPAD_DOWN]);
    self->select_1 = Button_from_ctrl(PIN_SELECT_1, profile->sections[SECTION_SELECT_1]);
    self->select_2 = Button_from_ctrl(PIN_SELECT_2, profile->sections[SECTION_SELECT_2]);
    self->start_2 = Button_from_ctrl(PIN_START_2, profile->sections[SECTION_START_2]);
    self->start_1 = Button_from_ctrl(PIN_START_1, profile->sections[SECTION_START_1]);
    self->l1 = Button_from_ctrl(PIN_L1, profile->sections[SECTION_L1]);
    self->l2 = Button_from_ctrl(PIN_L2, profile->sections[SECTION_L2]);
    self->r1 = Button_from_ctrl(PIN_R1, profile->sections[SECTION_R1]);
    self->r2 = Button_from_ctrl(PIN_R2, profile->sections[SECTION_R2]);
    self->l4 = Button_from_ctrl(PIN_L4, profile->sections[SECTION_L4]);
    self->r4 = Button_from_ctrl(PIN_R4, profile->sections[SECTION_R4]);
    // Rotary.
    CtrlRotary up = profile->sections[SECTION_ROTARY_UP].rotary;
    CtrlRotary down = profile->sections[SECTION_ROTARY_DOWN].rotary;
    Rotary rotary = Rotary_();
    rotary.config_mode(&rotary, 0, up.actions_0, down.actions_0);
    rotary.config_mode(&rotary, 1, up.actions_1, down.actions_1);
    rotary.config_mode(&rotary, 2, up.actions_2, down.actions_2);
    rotary.config_mode(&rotary, 3, up.actions_3, down.actions_3);
    rotary.config_mode(&rotary, 4, up.actions_4, down.actions_4);
    self->rotary = rotary;
    // Thumbsticks.
    thumbstick_from_ctrl(&(self->left_thumbstick), profile, 0);
    thumbstick_from_ctrl(&(self->right_thumbstick), profile, 1);
    // Dhat.
    self->dhat = Dhat_(
        Button_from_ctrl(PIN_VIRTUAL, profile->sections[SECTION_RSTICK_LEFT]),
        Button_from_ctrl(PIN_VIRTUAL, profile->sections[SECTION_RSTICK_RIGHT]),
        Button_from_ctrl(PIN_VIRTUAL, profile->sections[SECTION_RSTICK_UP]),
        Button_from_ctrl(PIN_VIRTUAL, profile->sections[SECTION_RSTICK_DOWN]),
        Button_from_ctrl(PIN_VIRTUAL, profile->sections[SECTION_RSTICK_UL]),
        Button_from_ctrl(PIN_VIRTUAL, profile->sections[SECTION_RSTICK_UR]),
        Button_from_ctrl(PIN_VIRTUAL, profile->sections[SECTION_RSTICK_DL]),
        Button_from_ctrl(PIN_VIRTUAL, profile->sections[SECTION_RSTICK_DR]),
        Button_from_ctrl(PIN_VIRTUAL, profile->sections[SECTION_RSTICK_PUSH]));
    // Gyro.
    CtrlGyro ctrl_gyro = profile->sections[SECTION_GYRO_SETTINGS].gyro;
    CtrlGyroAxis ctrl_gyro_x = profile->sections[SECTION_GYRO_X].gyro_axis;
    CtrlGyroAxis ctrl_gyro_y = profile->sections[SECTION_GYRO_Y].gyro_axis;
    CtrlGyroAxis ctrl_gyro_z = profile->sections[SECTION_GYRO_Z].gyro_axis;
    self->gyro = Gyro_(
        ctrl_gyro.mode,
        ctrl_gyro.engage);
    self->gyro.config_x(
        &(self->gyro),
        (int8_t)ctrl_gyro_x.angle_min,
        (int8_t)ctrl_gyro_x.angle_max,
        ctrl_gyro_x.actions_neg,
        ctrl_gyro_x.actions_pos);
    self->gyro.config_y(
        &(self->gyro),
        (int8_t)ctrl_gyro_y.angle_min,
        (int8_t)ctrl_gyro_y.angle_max,
        ctrl_gyro_y.actions_neg,
        ctrl_gyro_y.actions_pos);
    self->gyro.config_z(
        &(self->gyro),
        (int8_t)ctrl_gyro_z.angle_min,
        (int8_t)ctrl_gyro_z.angle_max,
        ctrl_gyro_z.actions_neg,
        ctrl_gyro_z.actions_pos);
}

Profile Profile_()
{
    Profile profile;
    profile.report = Profile__report;
    profile.reset = Profile__reset;
    profile.load_from_config = Profile__load_from_config;
    return profile;
}

// ============================================================================
// Independent functions.

void profile_reset_all_profiles()
{
    config_tune_set_mode(0);
    for (uint8_t i = 0; i < PROFILE_SLOTS; i++)
    {
        profiles[i].reset(&profiles[i]);
    }
}

void profile_update_leds()
{
    if (profile_led_lock)
        return;
    if (home_is_active)
    {
        led_static_mask(LED_ALL);
        if (profile_active_index == 1)
            led_blink_mask(LED_UP);
        if (profile_active_index == 2)
            led_blink_mask(LED_RIGHT);
        if (profile_active_index == 3)
            led_blink_mask(LED_DOWN);
        if (profile_active_index == 4)
            led_blink_mask(LED_LEFT);
        if (profile_active_index == 5)
            led_blink_mask(LED_TRIANGLE_UP);
        if (profile_active_index == 6)
            led_blink_mask(LED_TRIANGLE_RIGHT);
        if (profile_active_index == 7)
            led_blink_mask(LED_TRIANGLE_DOWN);
        if (profile_active_index == 8)
            led_blink_mask(LED_TRIANGLE_LEFT);
        if (profile_active_index == 9)
            led_blink_mask(LED_UP + LED_RIGHT);
        if (profile_active_index == 10)
            led_blink_mask(LED_RIGHT + LED_DOWN);
        if (profile_active_index == 11)
            led_blink_mask(LED_DOWN + LED_LEFT);
        if (profile_active_index == 12)
            led_blink_mask(LED_LEFT + LED_UP);
        led_set_mode(LED_MODE_BLINK);
    }
    else
    {
        if (profile_active_index == 1)
            led_idle_mask(LED_UP);
        if (profile_active_index == 2)
            led_idle_mask(LED_RIGHT);
        if (profile_active_index == 3)
            led_idle_mask(LED_DOWN);
        if (profile_active_index == 4)
            led_idle_mask(LED_LEFT);
        if (profile_active_index == 5)
            led_idle_mask(LED_TRIANGLE_UP);
        if (profile_active_index == 6)
            led_idle_mask(LED_TRIANGLE_RIGHT);
        if (profile_active_index == 7)
            led_idle_mask(LED_TRIANGLE_DOWN);
        if (profile_active_index == 8)
            led_idle_mask(LED_TRIANGLE_LEFT);
        if (profile_active_index == 9)
            led_idle_mask(LED_UP + LED_RIGHT);
        if (profile_active_index == 10)
            led_idle_mask(LED_RIGHT + LED_DOWN);
        if (profile_active_index == 11)
            led_idle_mask(LED_DOWN + LED_LEFT);
        if (profile_active_index == 12)
            led_idle_mask(LED_LEFT + LED_UP);
        led_set_mode(LED_MODE_IDLE);
    }
}

void profile_reset_all()
{
    // Reset HID state matrix. Optionally keep certain actions.
    hid_matrix_reset(pending_reset_keep);
    // Reset all profiles runtimes.
    profile_reset_all_profiles();
    // Reset flags.
    pending_reset = false;
    pending_reset_keep = 0;
}

void profile_check_home_sleep()
{
    // Check if home button is held super long, and go to sleep.
    if (home_is_active && hold_home_to_sleep_ts)
    {
        uint64_t threshold = hold_home_to_sleep_ts + (CFG_HOME_SLEEP_TIME * 1000);
        if (time_us_64() > threshold)
        {
            info("Dormant mode requested by long press home\n");
            power_dormant();
        }
        // Disable hold-home-sleep if there were reports (home profile was used).
        if (profile_reported_inputs)
        {
            profile_reset_home_sleep(false);
        }
    }
}

void profile_report_active()
{
    // If protocol was changed.
    if (profile_protocol_was_changed >= 0 && !home_is_active)
    {
#ifdef DEVICE_ALPAKKA_V1
        // Notify dongle so it syncs on the same protocol.
        wireless_send_usb_protocol(profile_protocol_was_changed);
        sleep_ms(10); // Enough time for wireless packet to be sent.
#endif
        power_restart();
    }
    // Reset all profiles (state) if needed.
    if (pending_reset)
        profile_reset_all();
    // Report active profile.
    Profile *profile = profile_get_active(false);
    profile_reported_inputs = false;
    profile->report(profile);
    profile_check_home_sleep();
}

void profile_reset_home_sleep(bool now)
{
    if (now)
        hold_home_to_sleep_ts = time_us_64();
    else
        hold_home_to_sleep_ts = 0;
}

void profile_set_home(bool state)
{
    info("Profile: Home %s\n", state ? "on" : "off");
    home_is_active = state;
    if (state)
    {
        led_static_mask(LED_ALL);
        led_set_mode(LED_MODE_ENGAGE);
        profile_reset_home_sleep(true); // Init home-to-sleep timer.
    }
    else
    {
        profile_update_leds();
    }
    pending_reset = true;
}

void profile_set_home_gamepad(bool state)
{
    home_gamepad_is_active = state;
    if (state)
    {
        led_static_mask(LED_NONE);
        led_set_mode(LED_MODE_ENGAGE);
    }
    else
    {
        profile_update_leds();
    }
    pending_reset = true;
    pending_reset_keep = GAMEPAD_HOME; // Do not reset held gamepad home.
}

void profile_set_active(uint8_t index)
{
    // Reset hold-to-sleep countdown if user changes profile.
    profile_reset_home_sleep(true);
    // Change profile.
    if (index != profile_active_index)
    {
        info("Profile: Profile %i\n", index);
        profile_active_index = index;
        config_set_profile(index);
    }
    // Update frontal leds.
    profile_update_leds();
}

Profile *profile_get_active(bool strict)
{
    if (strict)
    {
        return &profiles[profile_active_index];
    }
    else
    {
        if (home_is_active)
            return &profiles[PROFILE_HOME];
        else if (home_gamepad_is_active)
            return &profiles[PROFILE_HOME_GAMEPAD];
        else
            return &profiles[profile_active_index];
    }
}

Profile *profile_get(uint8_t index)
{
    return &profiles[index];
}

uint8_t profile_get_active_index(bool strict)
{
    if (strict)
    {
        return profile_active_index;
    }
    else
    {
        if (home_is_active)
            return 0;
        else
            return profile_active_index;
    }
}

void profile_set_reported_inputs(bool value)
{
    profile_reported_inputs = value;
}

void profile_enable_all(bool value)
{
    enabled_all = value;
}

void profile_enable_abxy(bool value)
{
    enabled_abxy = value;
}

void profile_notify_protocol_changed(Protocol protocol)
{
    hid_set_allow_communication(false);
    profile_protocol_was_changed = (int8_t)protocol;
}

void profile_init()
{
    info("INIT: Profiles\n");
    // Home button setup.
    Actions actions = {PROC_HOME};
    Actions actions_secondary = {0, 0, 0, 0};
    Actions actions_terciary = {GAMEPAD_HOME, PROC_HOME_GAMEPAD, PROC_IGNORE_LED_WARNINGS};
    home = Button_(PIN_HOME, DOUBLE | IMMEDIATE, actions, actions_secondary, actions_terciary);
    // Profiles setup.
    for (uint8_t i = 0; i < PROFILE_SLOTS; i++)
    {
        profiles[i] = Profile_();
        profiles[i].load_from_config(&(profiles[i]), config_profile_read(i));
    }
    profile_set_active(config_get_profile());
}
