asahiba/alpakka-improve/firmware/alpakka/src/loop.c

// SPDX-License-Identifier: GPL-2.0-only
// Copyright (C) 2022, Input Labs Oy.

#include <stdio.h>
#include <stdlib.h>
#include <pico/stdlib.h>
#include <pico/time.h>
#include <tusb.h>
#include "loop.h"
#include "config.h"
#include "wireless.h"
#include "esp.h"
#include "led.h"
#include "bus.h"
#include "profile.h"
#include "touch.h"
#include "imu.h"
#include "hid.h"
#include "uart.h"
#include "logging.h"
#include "version.h"
#include "common.h"
#include "pin.h"
#include "power.h"
#include "webusb.h"

// -----------------------------------------------------
#include "hardware/vreg.h"
#include "hardware/clocks.h"
#define CFG_SYS_CLOCK_MHZ 220
#define PLL_SYS_KHZ (CFG_SYS_CLOCK_MHZ * 1000)

void SetSystemClockFrequency(uint32_t clk_khz, bool increase_voltage)
{
    if (clk_khz == 0)
        return;
    if (clk_khz == 125 * 1000) // pico默认频率
        return;
    if (increase_voltage)
    {
        vreg_set_voltage(VREG_VOLTAGE_1_30); // 大概超过270MHz就需要调电压，建议直接1.3V
    }
    if (!set_sys_clock_khz(clk_khz, true))
    {
        error("SetSystemClockFrequency error\n");
        exit(1);
    }
}
// -----------------------------------------------------

static DeviceMode device_mode = WIRED;
static bool battery_low = false;
static uint64_t system_clock = 0;

DeviceMode loop_get_device_mode()
{
    return device_mode;
}

void loop_set_battery_low(bool state)
{
    battery_low = state;
}

uint64_t has_system_clock()
{
    return !!system_clock;
}

uint64_t get_system_clock()
{
    return system_clock + (time_us_64() / 1000);
}

void set_system_clock(uint64_t time)
{
    system_clock = time - (time_us_32() / 1000);
    info("LOOP: System_clock=%llu\n", system_clock);
}

void wait_for_system_clock()
{
    info("Waiting for system clock\n");
    while (!has_system_clock())
    {
        tud_task();
        if (tud_ready())
        {
            webusb_read();
            webusb_flush();
        }
        sleep_ms(1);
    }
}

static void title(char *label)
{
    info("╔====================╗\n");
    info("║ Input Labs Oy.     ║\n");
    info("║ %s ║\n", label);
    info("╚====================╝\n");
    info("Firmware version: %s\n", VERSION);
#if defined DEVICE_ALPAKKA_V0
    info("Compilation target: Alpakka v0\n");
#elif defined DEVICE_ALPAKKA_V1
    info("Compilation target: Alpakka v1\n");
#elif defined DEVICE_DONGLE
    info("Compilation target: Dongle\n");
#elif defined DEVICE_LLAMA
    info("Compilation target: LLAMA\n");
#endif
    info("default system clock khz = %u\n", clock_get_hz(clk_sys));
    info("default usb clock khz = %u\n", clock_get_hz(clk_usb));
    info("default rtc clock khz = %u\n", clock_get_hz(clk_rtc));
    info("default adc clock khz = %u\n", clock_get_hz(clk_adc));
    SetSystemClockFrequency(PLL_SYS_KHZ, false);
    info("reset system clock khz = %u\n", clock_get_hz(clk_sys));
    info("reset usb clock khz = %u\n", clock_get_hz(clk_usb));
    info("reset rtc clock khz = %u\n", clock_get_hz(clk_rtc));
    info("reset adc clock khz = %u\n", clock_get_hz(clk_adc));
}

static void set_wired()
{
    info("LOOP: Wired\n");
    if (device_mode != WIRED)
        power_restart();
    device_mode = WIRED;
}

static void set_wireless()
{
#ifdef DEVICE_HAS_MARMOTA
    info("LOOP: Wireless\n");
    device_mode = WIRELESS;
    // Show the animation for a fixed time (in lack of a proper pairing system).
    led_show_cycle2();
    sleep_ms(FAKE_PAIR_TIME_MS);
    led_show();
    // Prepare UART.
    wireless_set_uart_data_mode(true);
#endif
}

static void set_inactive()
{
    info("LOOP: Inactive\n");
    device_mode = INACTIVE;
    led_board_set(false);
    esp_enable(false);
}

static void board_led()
{
#ifdef DEVICE_ALPAKKA_V1
    static uint8_t i = 0;
    static bool blink = false;
    i++;
    if (i == 100)
    {
        i = 0;
        if (!gpio_get(PIN_BATT_STAT_1))
        {
            led_board_set(true); // Led on indicates battery is charging.
        }
        else
        {
            if (battery_low)
            {
                blink = !blink;
                led_board_set(blink); // Blinking led if battery is low.
            }
            else
            {
                led_board_set(false);
            }
        }
    }
#endif
}

void loop_controller_init()
{
    led_init();
    stdio_uart_init();
    stdio_init_all();
    logging_init();
    title(LABEL_CONTROLLER);
    config_init();
    tusb_init();
#if DEVICE_ALPAKKA_V0 == 2
    bool usb = usb_wait_for_init(-1);
#else
    bool usb = usb_wait_for_init(USB_WAIT_FOR_INIT_MS);
#endif
    // wait_for_system_clock();
    bus_init();
    hid_init();
    thumbstick_init();
    touch_init();
    rotary_init();
    imu_init();
    profile_init();
    power_gpio_init();
    wireless_init();
    set_wired();
    if (!usb)
    { // Variable out of the #if block so it is always used.
#if defined DEVICE_ALPAKKA_V1
        set_wireless();
#endif
    }
    loop_run();
}

void loop_dongle_init()
{
    led_init();
    stdio_uart_init();
    stdio_init_all();
    logging_init();
    title(LABEL_DONGLE);
    config_init();
    tusb_init();
    usb_wait_for_init(-1); // Negative number = no timeout.
    // wait_for_system_clock();
    // bus_init();
    hid_init();
    wireless_init();
    set_wireless(); // Dongle is always in wireless mode.
    led_board_set(true);
    loop_run();
}

void loop_controller_task()
{
    // Write flash if needed.
    config_sync();
    // Gather values for input sources.
    profile_report_active();
    // Report to the correct channel.
    if (device_mode == WIRED)
    {
        static uint64_t last_report_ts = 0;
        uint64_t now = time_us_64();
        // Report to USB.
        bool reported = hid_report_wired();
        if (reported)
        {
            last_report_ts = now;
        }
        else
        {
            // If report fails repeatedly.
            if (last_report_ts && (now - last_report_ts) > REPORT_TIMEOUT_US)
            {
#if defined DEVICE_ALPAKKA_V0
                info("Dormant mode requested by loop task (no usb data)\n");
                power_dormant(); // In v0, go sleep.
#elif defined DEVICE_ALPAKKA_V1
                set_wireless(); // In v1, go wireless.
#endif
            }
        }
    }
    if (device_mode == WIRELESS)
    {
        wireless_controller_task();
        // Switch to wired if USB is connected (check once per second).
        static uint16_t i = 0;
        i++;
        if ((!(i % CFG_TICK_FREQUENCY)) && usb_is_connected())
            set_wired();
    }
    // Listen to UART commands.
    uart_listen_serial();
    // Update state of board LED.
    board_led();
}

void loop_dongle_task()
{
    static uint32_t last = 0;
    uint32_t now = time_us_32();
    if (device_mode == WIRELESS)
    {
        config_sync();
        wireless_dongle_task();
        tud_task();
        if (tud_ready())
        {
            webusb_read();
            webusb_flush();
        }
        uart_listen_serial();
        if (now > (last + USB_DONGLE_CHECK_US))
        {
            last = time_us_32();
            if (!usb_is_connected())
                set_inactive();
        }
    }
    if (device_mode == INACTIVE)
    {
        if (now > (last + USB_DONGLE_CHECK_US))
        {
            last = time_us_32();
            if (usb_is_connected())
                power_restart();
        }
    }
}

void loop_llama_init()
{
    stdio_uart_init();
    stdio_init_all();
    wireless_init();
    led_init();
    esp_flash();
}

void loop_run()
{
    info("LOOP: Main loop start\n");
    uint16_t i = 0;
    logging_set_onloop(true);
    while (true)
    {
        i++;
        // Start timer.
        uint32_t start = time_us_32();
// Task.
#if defined DEVICE_ALPAKKA_V0 || defined DEVICE_ALPAKKA_V1
        loop_controller_task();
#endif
#ifdef DEVICE_DONGLE
        loop_dongle_task();
#endif
        // Calculate used time.
        uint32_t used = time_us_32() - start;
        int32_t unused = CFG_TICK_INTERVAL_IN_US - (int32_t)used;
        // Timing stats.
        if (logging_get_level() >= LOG_DEBUG)
        {
            static float average = 0;
            static float max = 0;
            average += used;
            if (used > max)
                max = used;
            if (!(i % CFG_TICK_FREQUENCY))
            {
                info("Loop: avg=%.0f max=%.0f\n", average / 1000, max);
                average = max = 0;
            }
        }
        // Idling control.
        if (unused > 0)
            sleep_us((uint32_t)unused);
        else
        {
            info("+");
            sleep_us(0); // Allow IRQ to take over even if the controller is overwhelmed.
        };
    }
}
