asahiba/alpakka-improve/(commit log)

2025-08-04 文件结构更改
    [A1无线圆润版标准化排版.3mf, Alpakka单摇杆[优化3]上壳.stl, Alpakka单摇杆home键.stl, Alpakka双摇杆[1.1.3]上壳.stl, Alpakka双摇杆home键.stl, alpakka.blend, alpakka.kicad_pcb, alpakka.kicad_sch]
2025-08-05 增加迷你·外壳
    [A.stl, B.stl]
